helalsaeed2003/RoboticArm.github.io/literature-review.md

# Background – Literature Review

[← Back to Home](index.md)

---

*(To be updated with literature on robotic arm design, pick-and-place automation, computer vision in robotics, and vacuum gripping systems.)*
