helalsaeed2003/RoboticArm.github.io/resources.md

# Resources – Pre-Existing Software & Hardware

[← Back to Home](index.md)

---

## Software

- **Autodesk Inventor** – CAD modeling
- **Arduino IDE** – Firmware development
- **Python 3** – PC-side control application (`opencv-python`, `pygame`, `pyserial`, `numpy`)
- **ROS2** – Robot middleware (planned)
- **Gazebo** – Digital twin simulation (planned)

## Hardware

- Arduino R4
- L293D Motor Shield
- MG996R Servos (×3)
- JGA25-370 DC Gearmotor with Quadrature Encoder
- USB Camera
- IMU Sensor
- Vacuum Suction Cup + Pump (TBD)
- 3D Printed Structural Parts
