helalsaeed2003/RoboticArm.github.io/pages/presentations.md

# Weekly Presentations

[← Back to Home](../index.md)

---

These are the weekly progress presentations delivered throughout the MEC 483 semester. Each slide deck covers what was accomplished that week, blockers encountered, and plans for the next sprint. They document the project's evolution from initial concept through final integration.

---

| Week | Presentation | Focus |
|---|---|---|
| 2 | [RoboticArm_Week2.pptx](../media/PowerPoints/RoboticArm_Week2.pptx) | Project proposal and initial scope definition |
| 3 | [RoboticArm_Week3.pptx](../media/PowerPoints/RoboticArm_Week3.pptx) | Requirements gathering and component selection |
| 4 | [RoboticArm_Week4.pptx](../media/PowerPoints/RoboticArm_Week4.pptx) | Mechanical design and CAD modelling |
| 5 | [RoboticArm_Week5.pptx](../media/PowerPoints/RoboticArm_Week5.pptx) | Electrical schematic and power system layout |
| 6 | [RoboticArm_Week6.pptx](../media/PowerPoints/RoboticArm_Week6.pptx) | Firmware development and servo testing |
| 7 | [RoboticArm_Week7.pptx](../media/PowerPoints/RoboticArm_Week7.pptx) | Computer vision pipeline and YOLOv11 training |
| 8 | [RoboticArm_Week8.pptx](../media/PowerPoints/RoboticArm_Week8.pptx) | Manual control interface and gamepad integration |
| 10 | [RoboticArm_Week10.pptx](../media/PowerPoints/RoboticArm_Week10.pptx) | System integration and automatic mode testing |
| 11 | [RoboticArm_Week11.pptx](../media/PowerPoints/RoboticArm_Week11.pptx) | End effector validation and pick testing |
| 12 | [RoboticArm_Week12.pptx](../media/PowerPoints/RoboticArm_Week12.pptx) | Final demo, results, and lessons learned |

> Week 9 was a university break — no presentation that week.

---

[← Back to Home](../index.md)
