helalsaeed2003/RoboticArm.github.io/pages/references.md

# References

[← Back to Home](../index.md)

---

1. W. Bolton, *Mechatronics: Electronic Control Systems in Mechanical and Electrical Engineering*, 7th ed., Harlow, U.K.: Pearson, 2019.
2. M. W. Spong, S. Hutchinson, M. Vidyasagar, *Robot Modeling and Control*, 2nd ed., Wiley, 2020.
3. J. J. Craig, *Introduction to Robotics: Mechanics and Control*, 4th ed., Pearson, 2018.
4. N. S. Nise, *Control Systems Engineering*, 8th ed., Wiley, 2019.
5. J. Redmon, S. Divvala, R. Girshick, A. Farhadi, "You Only Look Once: Unified, Real-Time Object Detection," *IEEE CVPR*, 2016.
6. G. Bradski, A. Kaehler, *Learning OpenCV*, O'Reilly Media, 2008.
7. G. Jocher, A. Chaurasia, J. Qiu, "Ultralytics YOLOv11," 2024. https://github.com/ultralytics/ultralytics
8. M. Quigley et al., "ROS: An Open-Source Robot Operating System," *ICRA Workshop on Open Source Software*, 2009.
9. InvenSense, *MPU-6000 and MPU-6050 Product Specification*, rev. 3.4, 2013.
10. STMicroelectronics, *L298 Dual Full-Bridge Driver Datasheet*. https://www.st.com/resource/en/datasheet/l298.pdf
11. Tower Pro, *MG996R High-Torque Metal-Gear Servo Datasheet*, 2019.
12. Roboflow Inc., "Roboflow: Annotate, Train, and Deploy Computer-Vision Models," 2024. https://roboflow.com/
13. Processing Foundation, "Processing — A Flexible Software Sketchbook," 2024. https://processing.org/
14. P. Lager, "GameControlPlus Library for Processing," 2018. http://www.lagers.org.uk/gamecontrol

---

[← Back to Home](../index.md)
