helalsaeed2003/RoboticArm.github.io/Pages/prototype.md

# Prototype Construction

[← Back to Home](../index.md)

---

## Initial Design

- CAD model designed in Autodesk Inventor with ~400 mm reach
- Parts scaled and prepared for 3D printing
- Motor mounting holes and wiring channels added
- Wrist joint and end effector CAD in progress

## Final Design

*(To be updated after fabrication and assembly.)*
