helalsaeed2003/RoboticArm.github.io/media/PowerPoints/RoboticArm_Week10.pptx

WEEK 10

Robotic Arm

Pick & Place System

Weekly Progress Report · Mechatronics System Design 101

Leen's Group · Leen · Mohamed · Helal

## Slide 2

What we worked on this week

Week 10 — Snapshot

Status

Pump & relay working

12V pump, relay module, and lithium batteries wired up and controlled via Arduino. Relay successfully activates and deactivates the pump on command.

ROS2 — arm in environment

CAD model now appears at correct positions in ROS2 environment. Arm joints are controllable and can be manipulated in simulation.

Pump / relay

Working ✓

01

02

ROS2 / RViz

Working ✓

Arm assembly

Stable ✓

Arm assembly — stable

New screws procured — arm fits together perfectly and is structurally stable. Wheels received and ready to attach once base is complete.

Mobile base — laser cut

Laser cut base attempted twice — both broke. Redesigning with a simpler geometry before the third attempt.

Mobile base

03

04

Redesigning

End effector

In progress

Full assembly

Mechatronics System Design 101 · Leen's Group · Week 10

✓ Major progress: pump + relay operational, ROS2 arm controllable in simulation, arm structurally stable.

Pending

## Slide 3

Project Schedule — Gantt Chart

[ Paste Gantt Chart Image Here ]

Mechatronics System Design 101 · Leen's Group · Week 10

## Slide 4

Project Schedule — Gantt Chart

[ Paste Gantt Chart Image Here ]

Mechatronics System Design 101 · Leen's Group · Week 7

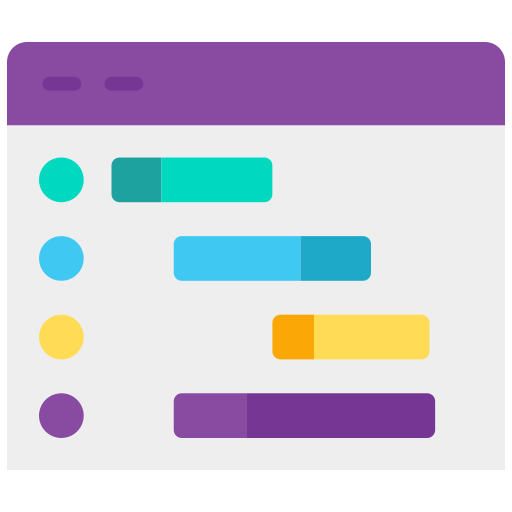
[picture p39: figure]

## Slide 5

Milestones & Deliverables

Deliverable

Target

Status

This week

CAD model complete

Week 10

Complete ✓

All links modelled — arm fits and is stable

Pump & relay control

Week 10

Done ✓

12V pump activated via relay and Arduino

ROS2 / Digital twin

Week 10

Working ✓

Arm at correct positions, joints manipulable

End effector (gripper)

Week 10

In progress

3D printing gripper design in progress

Mobile base

Week 10

Redesigning

Laser cut failed twice — simpler design planned

Full assembly

Week 11

Pending

Waiting on base and end effector completion

Control complete

Week 11

On track

Gamepad + Python + CV + relay all functional

Mechatronics System Design 101 · Leen's Group · Week 10

## Slide 6

Issues, Risks & Action Items

Current issues & risks

Mobile base — laser cut failing

Two laser cut attempts broke. Root cause: design too complex for the material. Redesigning with simpler geometry before third attempt.

Action items

Redesign base — simpler geometry

All

High

Week 11

End effector not yet complete

Gripper being 3D printed. End effector assembly cannot be finalised until print is complete and fit is verified.

Third laser cut attempt

All

Week 11

High

Complete gripper 3D print

Mohamed

Week 11

Attach wheels once base is ready

All

Full assembly blocked

Cannot fully assemble the system until both the mobile base and end effector are ready.

Medium

Week 11

Full system assembly

All

Week 11

Box dimensions still unknown

Professor has not yet provided box dimensions — coordinate mapping and arm positioning cannot be fully finalised.

Medium

Request box dimensions from professor

Leen

Week 11

Mechatronics System Design 101 · Leen's Group · Week 10

## Slide 7

Helal

Member

Individual

Updates

What each member did, what they will do, what they need.

Leen

Group Leader

Mohamed

Member

## Slide 8

Leen — Group Leader · ROS2 & Simulation

Accomplished (since last report)

- CAD model imported into ROS2 environment at correct joint positions

- Arm joints are now manipulable in the simulation

- Digital twin reflects the physical arm structure accurately

ROS2 / Digital twin — where we are

Installed & configured ✓

Installed and running ✓

Model at correct positions ✓

Joints manipulable in sim ✓

ROS2 ↔ Arduino — in progress

Ubuntu VM

ROS2

CAD import

In progress

- Linking ROS2 simulation to real Arduino control pipeline

- Finalising coordinate mapping for auto pick-and-place

Joint control

Arduino link

Full demo

Pending full assembly

Next week plan

- Connect ROS2 to Arduino for real-time joint control

- Complete full auto pick-and-place pipeline

- Request box dimensions from professor

Help needed / questions

Box dimensions still needed from professor to finalise arm positioning and coordinate mapping for pick-and-place.

Mechatronics System Design 101 · Leen's Group · Week 10

## Slide 9

Mohamed — Member

Accomplished (since last report)

[ To be filled in by Mohamed ]

Evidence (show, don't tell)

[ To be filled in by Mohamed ]

In progress

[ To be filled in by Mohamed ]

Help needed / questions

[ To be filled in by Mohamed ]

Next week plan

[ To be filled in by Mohamed ]

Mechatronics System Design 101 · Leen's Group · Week 10

## Slide 10

Helal — Member · Hardware & Assembly

Accomplished (since last report)

- Procured 12V pump, relay module, lithium batteries and case

- Wired relay module to Arduino — pump activates and deactivates on command

- Procured new screws — arm fits together and is structurally stable

- Received wheels — ready to attach once base is complete

- Laser cut base attempted twice — both attempts broke

Electrical system — what was bought

12V DC mini vacuum pump

3× 3.7V lithium batteries in series (~11.1V)

Relay module — Arduino-controlled on/off for pump

2× DC motors + wheels for mobile base

L298D motor driver shield for DC motors

New M3 screws — arm assembly now stable

Pump

Power

Relay

Motors

In progress

- Redesigning base with simpler geometry for third laser cut attempt

Driver

Screws

Help needed / questions

Base material and design needs to be validated before cutting again — two failed attempts. Need to confirm final dimensions and cut settings before third attempt.

Next week plan

- Third laser cut attempt with simplified base design

- Attach wheels and DC motors to base

- Begin full system assembly

Mechatronics System Design 101 · Leen's Group · Week 10

## Slide 11

Looking ahead

Week 10

Wrap-up

✓

✓

Pump + relay + batteries — working and controlled by Arduino

ROS2 arm at correct positions in simulation — joints manipulable

Week 11

Simplified base — third laser cut

✓

Arm structurally stable — new screws fit perfectly

Finish gripper + end effector

✓

Wheels and DC motors received

Week 11

Attach wheels + motors to base

⚠

Mobile base laser cut failed twice — redesigning for third attempt

Week 11

Full system assembly

⚠

End effector / gripper still being 3D printed

Week 11

ROS2 ↔ Arduino live link

Full pick-and-place demo

✗

Box dimensions still not received from professor

Week 11

Week 11

Mechatronics System Design 101 · Leen's Group · Week 10
