helalsaeed2003/RoboticArm.github.io/media/PowerPoints/RoboticArm_Week11.pptx

WEEK 11

Robotic Arm

Pick & Place System

Weekly Progress Report · Mechatronics System Design 101

Leen's Group · Leen · Mohamed · Helal

## Slide 2

Week 11 — Snapshot

What we worked on this week

Status

Full manual control working

Gamepad now controls wheel motors, all servo joints, and the pump in a single unified control loop. Full manual operation of the system confirmed.

Mobile base — laser cut done

Two platforms successfully laser cut. Standoffs procured to space them apart. Base structure is coming together.

Manual control

Working ✓

01

02

Mobile base

In progress

ROS2

In progress

CAD — scale verification needed

Further progress on CAD model. Printed parts need to be measured and compared to CAD to correct any scale discrepancies.

Detection — retraining model

Collected more images in a crowded environment. Model will be retrained to improve detection accuracy in realistic conditions.

CAD

03

04

Scale check

Detection

Retraining

End effector

✓ Major win: full manual control of wheels, servos, and pump confirmed working from a single gamepad.

Mechatronics System Design 101 · Leen's Group · Week 11

No update

## Slide 3

Project Schedule — Gantt Chart

[ Paste Gantt Chart Image Here ]

Mechatronics System Design 101 · Leen's Group · Week 11

## Slide 4

Milestones & Deliverables

Deliverable

Target

Status

This week

Manual control (full)

Week 11

Done ✓

Wheels + servos + pump via gamepad — all working

Mobile base

Week 11

In progress

Two platforms laser cut — standoffs fitted

CAD model

Week 11

Scale check

Progress made — need to verify printed part dimensions

Detection model

Week 11

Retraining

More images collected — model retraining in progress

ROS2 / Digital twin

Week 11

In progress

Joint positions not yet connecting correctly

End effector

Week 11

No update

Gripper 3D print status unchanged

Full system assembly

Week 11

Pending

Waiting on base, end effector, and CAD scale fix

Mechatronics System Design 101 · Leen's Group · Week 11

## Slide 5

Issues, Risks & Action Items

Current issues & risks

ROS2 — joints not connecting

Worked on ROS2 this week but arm parts are not connecting at the correct positions in the simulation. Configuration still needed.

Action items

Fix ROS2 joint connection positions

Mohamed

High

Next week

CAD scale discrepancy

Printed parts may not match CAD dimensions exactly. Need to measure and compare before adjusting the model.

Measure printed parts vs CAD — adjust

Helal

Next week

Medium

Retrain detection model

Leen

Next week

Resolve end effector / gripper

Mohamed

End effector — no progress

Gripper 3D print has had no update. End effector assembly cannot proceed until this is resolved.

Medium

Next week

Complete base — attach wheels & motors

Helal

Next week

Full assembly still pending

Assembly blocked until base is complete, end effector is ready, and CAD scale is confirmed.

Medium

Begin full system assembly

All

Next week

Mechatronics System Design 101 · Leen's Group · Week 11

## Slide 6

Individual

Updates

What each member did, what they will do, what they need.

Helal

Member

Leen

Group Leader

Mohamed

Member

## Slide 7

Leen — Group Leader · Detection & Image Collection

Accomplished (since last report)

- Collected additional training images in a crowded environment

- Images captured across varied lighting and background conditions

- Dataset prepared — model retraining queued

Why crowded environment training?

Earlier model trained on clean backgrounds — fails when other objects or clutter are present

New images captured with multiple objects in frame — teaches model to isolate the target

Robust detection in real lab conditions regardless of surrounding clutter

Problem

Solution

In progress

- Retraining detection model on expanded crowded-environment dataset

Goal

Next week plan

- Complete model retraining and evaluate accuracy

- Test retrained model on live camera feed

- Integrate updated detection with Arduino command pipeline

- Finalise coordinate mapping once box dimensions are confirmed

Help needed / questions

Box dimensions still needed from professor — coordinate mapping for the pick-and-place sequence cannot be finalised without knowing where the boxes will be placed.

Mechatronics System Design 101 · Leen's Group · Week 11

## Slide 8

Mohamed — Member · ROS2 Integration

Accomplished (since last report)

- Continued work on ROS2 — arm model loaded into simulation environment

ROS2 / Digital twin — current state

Installed & running ✓

Installed & running ✓

Model loaded in sim ✓

Not connecting correctly — in progress

Not yet started

Pending joint fix + assembly

Ubuntu VM

ROS2

In progress

- Arm parts not yet connecting at correct positions in ROS2 — joint transforms being debugged

CAD import

Joint positions

Arduino link

Next week plan

- Fix joint transform positions in URDF

- Verify arm model matches physical arm geometry

- Begin ROS2 ↔ Arduino live control link

- Resolve end effector / gripper status

Full demo

Help needed / questions

URDF joint transforms are not placing parts at correct positions — need to review axis definitions and parent-child relationships in the URDF file.

Mechatronics System Design 101 · Leen's Group · Week 11

## Slide 9

Helal — Member · Control, CAD & Base

Accomplished (since last report)

- Completed unified manual control code — gamepad drives wheel motors, actuates all servo joints, and activates pump simultaneously

- Two base platforms successfully laser cut

- Standoffs procured to space the two platforms apart

- Further progress on CAD model

Manual control — what the gamepad controls

Drive wheel motors — forward / backward / turn

Shoulder and elbow servo joints

Wrist servo — up/down

Pump on/off via relay

Base joint rotation

Left stick

Right stick

Triggers

Buttons

Bumpers

In progress

- Measuring printed parts to check scale against CAD model

Single unified Arduino firmware sketch

All modes

Help needed / questions

Printed parts may be scaled down relative to the CAD. Need to physically measure each part and update the CAD before the model can be used for final assembly planning.

Next week plan

- Adjust CAD model based on measured part dimensions

- Assemble base — attach wheels and DC motors

- Begin full system assembly

Mechatronics System Design 101 · Leen's Group · Week 11

## Slide 10

Looking ahead

Week 11

Wrap-up

Full manual control — wheels, servos, and pump via single gamepad

✓

Fix ROS2 joint transforms

Next

Mobile base platforms laser cut — standoffs fitted

✓

Retrain + test detection model

More training images collected in crowded environment

CAD scale needs verification against printed parts

✓

⚠

Verify CAD scale + adjust

Next

ROS2 joint positions not yet connecting correctly

⚠

Assemble base + attach wheels

Next

End effector / gripper — no update this week

⚠

Next

Resolve end effector

Full system assembly + demo

Next

Next

Mechatronics System Design 101 · Leen's Group · Week 11
