helalsaeed2003/RoboticArm.github.io/media/PowerPoints/RoboticArm_Week12.pptx

WEEK 12

Robotic Arm

Pick & Place System

Weekly Progress Report · Mechatronics System Design 101

Leen's Group · Leen · Mohamed · Helal

## Slide 2

Week 12 — Snapshot

What we worked on this week

Status

Detection — simplified & improved

Decided egg and ball are similar enough in size — system detects object presence rather than classifying type. Detection now more reliable and practical.

End effector — parts acquired

Tube, connector, and suction cup procured. Gripper still needs to be printed. One connecting part failed to print and needs to be reprinted.

Mobile base

Assembled ✓

01

02

Detection

Simplified ✓

Pump

Tested ✓

Mobile base — fully assembled

Both platforms drilled, 4 columns fitted between them, wheels on bottom platform, hole in top platform for wire routing. Arduino seated between the two bases.

Pump — tested

Pump tested with the suction cup and tubing. Suction force verified on representative objects.

End effector

03

04

In progress

Gripper print

Pending

Full assembly

✓ Major win: mobile base fully assembled — wheels, columns, wire routing, and Arduino housing all complete.

Mechatronics System Design 101 · Leen's Group · Week 12

Near ready

## Slide 3

Project Schedule — Gantt Chart

[ Paste Gantt Chart Image Here ]

Mechatronics System Design 101 · Leen's Group · Week 12

## Slide 4

Milestones & Deliverables

Deliverable

Target

Status

This week

Mobile base

Week 12

Done ✓

Drilled, columns fitted, wheels on, wire hole cut

Detection system

Week 12

Done ✓

Simplified — detects object presence reliably

Pump testing

Week 12

Done ✓

Suction confirmed working with tube and cup

End effector (suction)

Week 12

In progress

Tube, connector, cup acquired — needs connector part reprint

Gripper print

Week 12

Pending

Still needs to be printed

Full assembly

Week 12

Near ready

Blocked only by gripper and failed part reprint

Control complete

Week 12

On track

Manual control fully working — auto pending CV

Mechatronics System Design 101 · Leen's Group · Week 12

## Slide 5

Issues, Risks & Action Items

Current issues & risks

Failed part print — end effector

One part that connects to the end effector failed to print. Needs to be reprinted before the end effector can be fully assembled.

Action items

Reprint failed end effector connector

Helal

High

Next week

Gripper not yet printed

Gripper design still needs to be printed. End effector assembly cannot be completed until this is done.

Print gripper

Mohamed

Next week

High

Assemble full end effector

All

Next week

Full system assembly

All

Full assembly pending

All other components are ready — assembly is blocked only by the two missing printed parts.

Medium

Next week

Fix ROS2 joint transforms

Mohamed

Next week

ROS2 joint positions

Joint connection issue from last week not yet resolved. Integration with live control still pending.

Medium

Test full pick-and-place cycle

All

Next week

Mechatronics System Design 101 · Leen's Group · Week 12

## Slide 6

Individual

Updates

What each member did, what they will do, what they need.

Helal

Member

Leen

Group Leader

Mohamed

Member

## Slide 7

Leen — Group Leader · Detection & End Effector

Accomplished (since last report)

- Improved and simplified detection system — egg and ball treated as same object category since sizes are nearly identical

- System now detects object presence reliably without needing exact classification

- Procured suction tube, connector, and suction cup for end effector assembly

Detection — design decision

Classify object type (bolt, egg, ball) separately — complex and error-prone

Detect that an object is present and in range — simpler and more reliable

Egg and ball are nearly identical in size — separate classification adds unnecessary complexity

Detection is now faster, more reliable, and easier to integrate with the control pipeline

Old approach

New approach

Justification

In progress

- Integrating updated detection with the full auto control pipeline

Result

End effector — parts status

Procured ✓

Procured ✓

Procured ✓

Next week plan

- Complete end effector assembly once reprints arrive

- Test full detection-to-command pipeline

- Begin full pick-and-place cycle testing

Suction cup

Tube

Connector

Failed — needs reprint

Connector part (3D print)

Mechatronics System Design 101 · Leen's Group · Week 12

Not yet printed

Gripper

## Slide 8

Mohamed — Member · Base Assembly & Pump Testing

Accomplished (since last report)

- Assisted with drilling both circular base platforms

- Helped assemble base structure — columns, wheels, and wire routing hole

- Tested pump suction with tube and cup — confirmed working on representative objects

Pump test results

Picked up successfully ✓

Picked up successfully ✓

Picked up successfully ✓

Cup seals on flat and curved surfaces ✓

Bolt

Ball

Egg

In progress

- Gripper design — needs to be printed

Seal

Help needed / questions

Gripper print is the last remaining blocker for end effector completion. Once printed and assembled, full system testing can begin. ROS2 joint transform issue still needs to be resolved before digital twin can mirror real arm.

Next week plan

- Print gripper

- Assemble full end effector

- Fix ROS2 joint position issue

- Begin full system assembly and testing

Mechatronics System Design 101 · Leen's Group · Week 12

## Slide 9

Helal — Member · Base Assembly & End Effector

Accomplished (since last report)

- Drilled both circular base platforms

- Fitted 4 standoff columns between the two platforms

- Attached wheels to bottom platform

- Cut wire routing hole in top platform

- Arduino seated and secured between the two platforms

- Procured suction tube, connector, and suction cup

Mobile base — what was built

Circular — drilled — wire hole cut for Arduino wiring

Seated between platforms — wires routed through top hole

4× standoffs spacing the two platforms apart

Circular — drilled — wheels attached underneath

DC motors + wheels on bottom for mobile movement

Batteries and relay housed in base structure

Top platform

Arduino

Columns

Bottom platform

In progress

- Reprint of failed end effector connector part

Wheels

Power

Next week plan

- Reprint connector part and assemble end effector

- Attach wheels and DC motors to base

- Begin full system assembly

Help needed / questions

Connector part reprint is the only remaining blocker before end effector can be assembled.

Mechatronics System Design 101 · Leen's Group · Week 12

## Slide 10

Looking ahead

Week 12

Wrap-up

Mobile base fully assembled — drilled, columns, wheels, wire routing

Detection simplified — object presence detection, egg/ball treated as one

✓

✓

Reprint connector + print gripper

Next

Pump tested — all three objects picked up successfully

✓

Assemble full end effector

End effector parts procured — tube, connector, suction cup

✓

Attach wheels + motors to base

Next

Connector part failed to print — needs reprinting

⚠

Full system assembly

Next

Gripper not yet printed — last blocker for end effector

⚠

Next

Fix ROS2 joint transforms

Full pick-and-place demo

ROS2 joint positions still not resolved

⚠

Next

Next

Mechatronics System Design 101 · Leen's Group · Week 12
