helalsaeed2003/RoboticArm.github.io/media/PowerPoints/RoboticArm_Week4.pptx

WEEK 4

Robotic Arm

Pick & Place System

Weekly Progress Report · Mechatronics System Design 101

March 25 – March 31, 2025

Leen's Group · Leen · Mohamed · Helal

## Slide 2

Week 4 — Snapshot

What we worked on this week

CAD model update

Continued refining the arm model in Autodesk Inventor. Wrist joint and end effector mount still in progress — geometry for base, shoulder, and elbow is locked.

Status

Schedule

On track

01

OpenCV — computer vision

Started setting up the OpenCV pipeline on the PC. Color/shape-based object detection approach being prototyped — no AI training required.

Scope

Defined

02

CAD

In progress

Hardware

Procured

Electrical components & code

Procured electrical components including Arduino R3, motor driver, and servo set. Began bench testing of Arduino code — basic servo PWM control verified and responding correctly.

03

Code

Testing

Mechatronics System Design 101 · Leen's Group · Week 4

⚠ CAD wrist joint and end effector mount still require work — targeted for completion by Week 6.

## Slide 3

Project Schedule — Gantt Chart

[ Paste Gantt Chart Image Here ]

Mechatronics System Design 101 · Leen's Group · Week 4

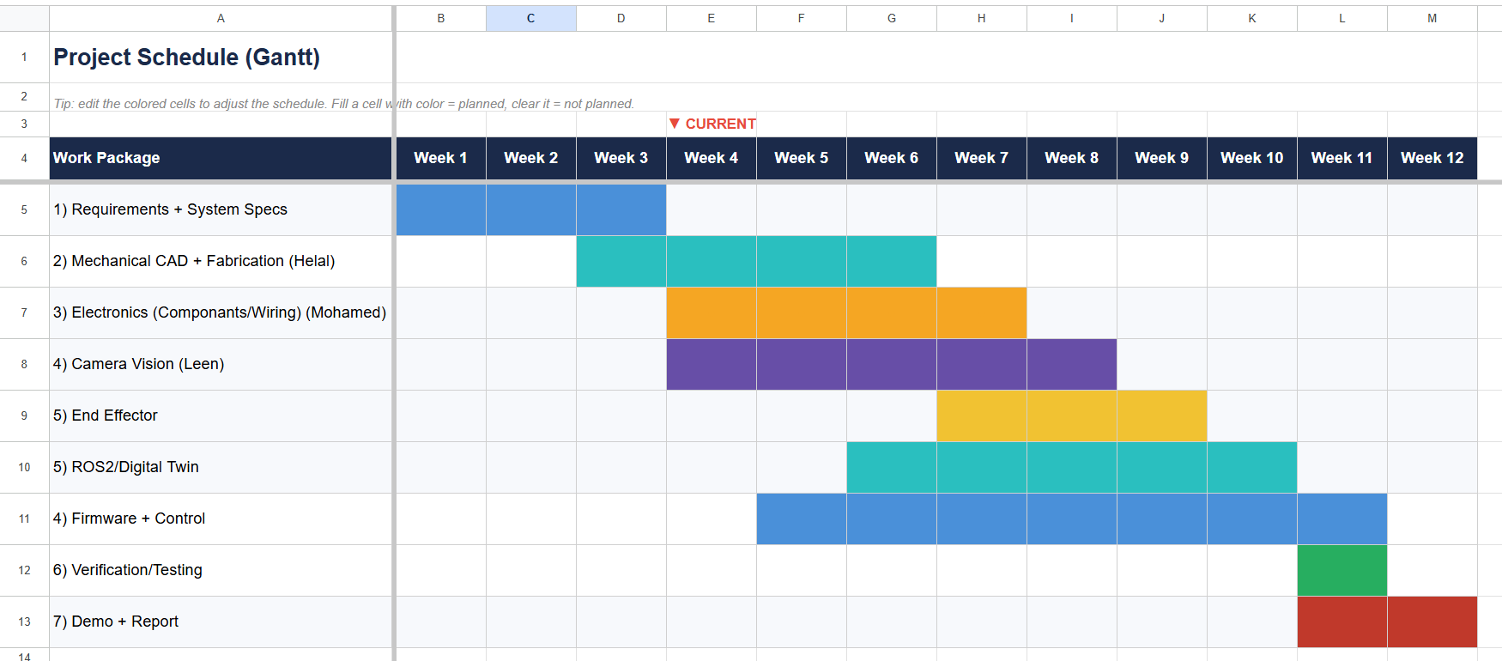
[picture p40: figure]

## Slide 4

Milestones & Deliverables

Deliverable

Target

Status

Progress this week

CAD model complete

Week 6

In progress

Base/shoulder/elbow done. Wrist & EE mount in progress.

Camera vision (OpenCV)

Week 8

Started

Color/shape detection pipeline being prototyped on PC.

End effector

Week 9

Planned

Custom design pending CAD completion. Pump/Comp TBD.

ROS2 & digital twin

Week 10

Started

ROS2 environment set up. Gazebo simulation begun.

Full assembly

Week 10

Planned

3D printing of parts started for early fit testing.

Control system integration

Week 11

Planned

PC + Arduino R4 serial comms. Arduino code prototyped.

✓ This week: electrical components procured, 3D printing of arm parts started, Arduino code testing begun.

Mechatronics System Design 101 · Leen's Group · Week 4

## Slide 5

Issues, Risks & Actions

Current issues & risks

Suction pump undecided

Still evaluating mini compressor vs micro diaphragm pump vs venturi. Affects end effector timeline.

Actions & mitigations

Pump selection

Test available options in lab Week 5 — select based on suction force and size fit.

Medium

Pending

CAD wrist & end effector

Wrist joint and end effector mount geometry not yet finalised — blocking 3D print of those parts.

Medium

CAD completion

Wrist and EE mount to be finalised by Week 6. Scale and wiring routing to follow.

In progress

Team coordination

Difficulty scheduling meetings and exchanging work between members due to conflicting availability.

Team sync

Set a fixed weekly check-in slot. Use shared drive for exchanging files between members.

High

In progress

ROS2 learning curve

ROS2 and Gazebo are new to the team — early stage setup taking longer than anticipated.

High

ROS2 ramp-up

Team to follow ROS2 + Gazebo tutorials in parallel. Simple URDF model targeted for Week 6.

In progress

Mechatronics System Design 101 · Leen's Group · Week 4

## Slide 6

Helal

Member

Individual

Updates

What each member did, what they will do, what they need.

Leen

Group Leader

Mohamed

Member

## Slide 7

Leen — Group Leader · Vision & Detection

Accomplished (since last report)

- Secured and confirmed the camera to be used for the project

- Researched OpenCV vs YOLOv4 for object detection

- Decided on OpenCV color/shape detection — no training needed, better fit for controlled lab environment

OpenCV vs YOLOv4 — decision rationale

OpenCV ✓

- No training required

- Works with controlled lighting

- Simpler to implement & debug

YOLOv4 ✗

- Requires training data & GPU

- Overkill for a fixed lab setup

In progress

- Setting up OpenCV detection pipeline on PC with connected camera

Next week plan

- Begin implementing OpenCV detection script on PC

- Test camera feed and object detection on sample items

- Integrate detection output with serial command pipeline

Help needed / questions

No blockers this week. Camera secured and detection approach confirmed — ready to begin coding pipeline.

Mechatronics System Design 101 · Leen's Group · Week 4

## Slide 8

Leen — Group Leader · Vision & Detection

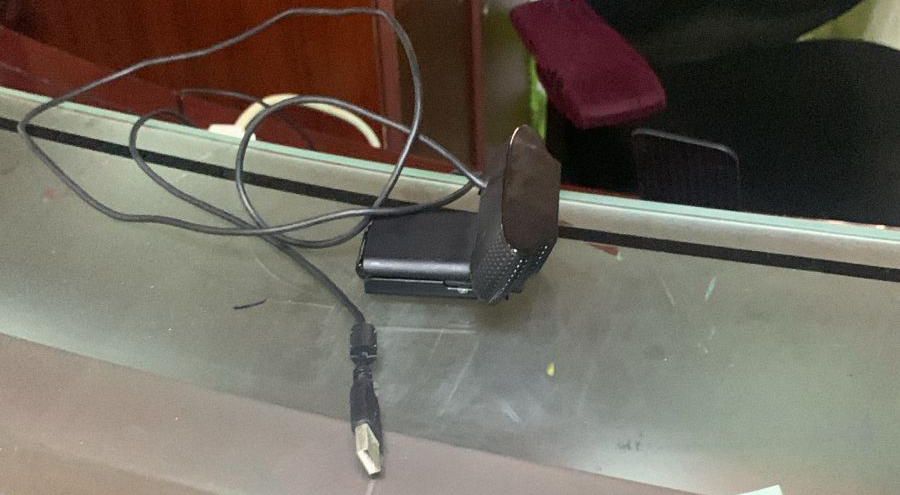
[picture p41: figure]

Mechatronics System Design 101 · Leen's Group · Week 4

## Slide 9

Mohamed — Member

Components Purchased

4× MG996R Servo Motors

L293D Motor Shield (H-Bridge)

400mm Male-Male Jumper Wires

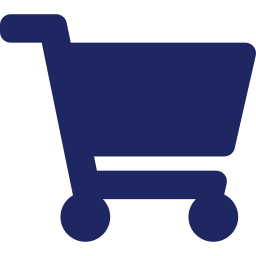
[picture p42: figure]

Arduino Code

2-DOF serial servo controller

Base & Shoulder joints (pins 9 & 10)

Serial command parsing

Input validation & status query

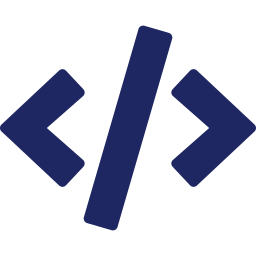
[picture p43: figure]

Week 4 • Mohamed • Robotic Arm Project

## Slide 10

Mohamed — Member

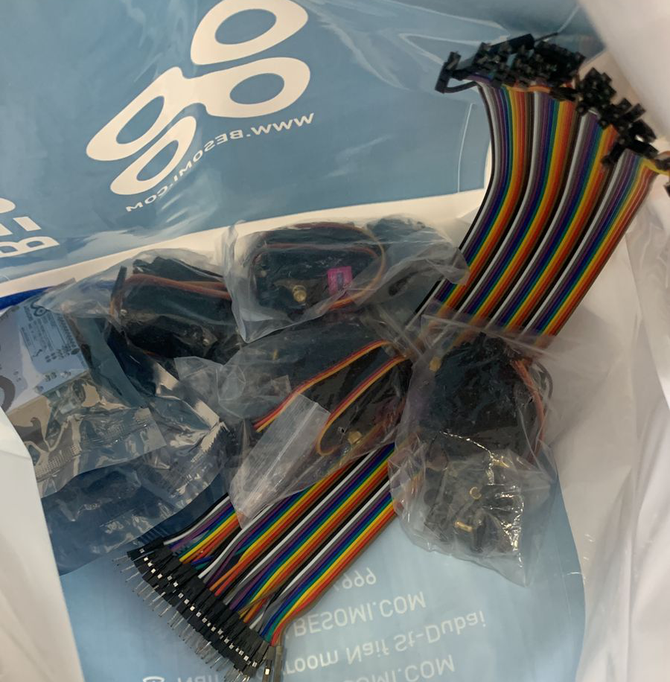
[picture p44: figure]

Week 4 • Mohamed • Robotic Arm Project

## Slide 11

Mohamed — Member
Components Purchased

MG996R Servo Motors ×4

Actuates the shoulder, elbow, wrist, and gripper joints

Torque: 9.4 kg·cm (4.8V) / 11 kg·cm (6V)

Speed: 0.17 s/60° at 4.8V

Angle range: 0°–180°

Protocol: PWM signal

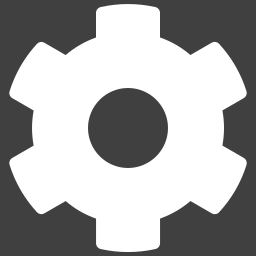
[picture p45: figure]

L293D Motor Shield

Interfaces servos and DC motor with the Arduino R4

Dual H-Bridge driver (L293D chip)

Servo headers on pins 9 & 10

Supports up to 4 DC motors

Direct stacking on Arduino

400mm Jumper Wires (M-M)

Internal wiring between components on the arm

Length: 400 mm

Type: Male-to-Male

Flexible routing for arm assembly

Week 4 • Mohamed • Robotic Arm Project

## Slide 12

Mohamed — Member
Arduino Code — 2-DOF Servo Controller

Arduino Sketch

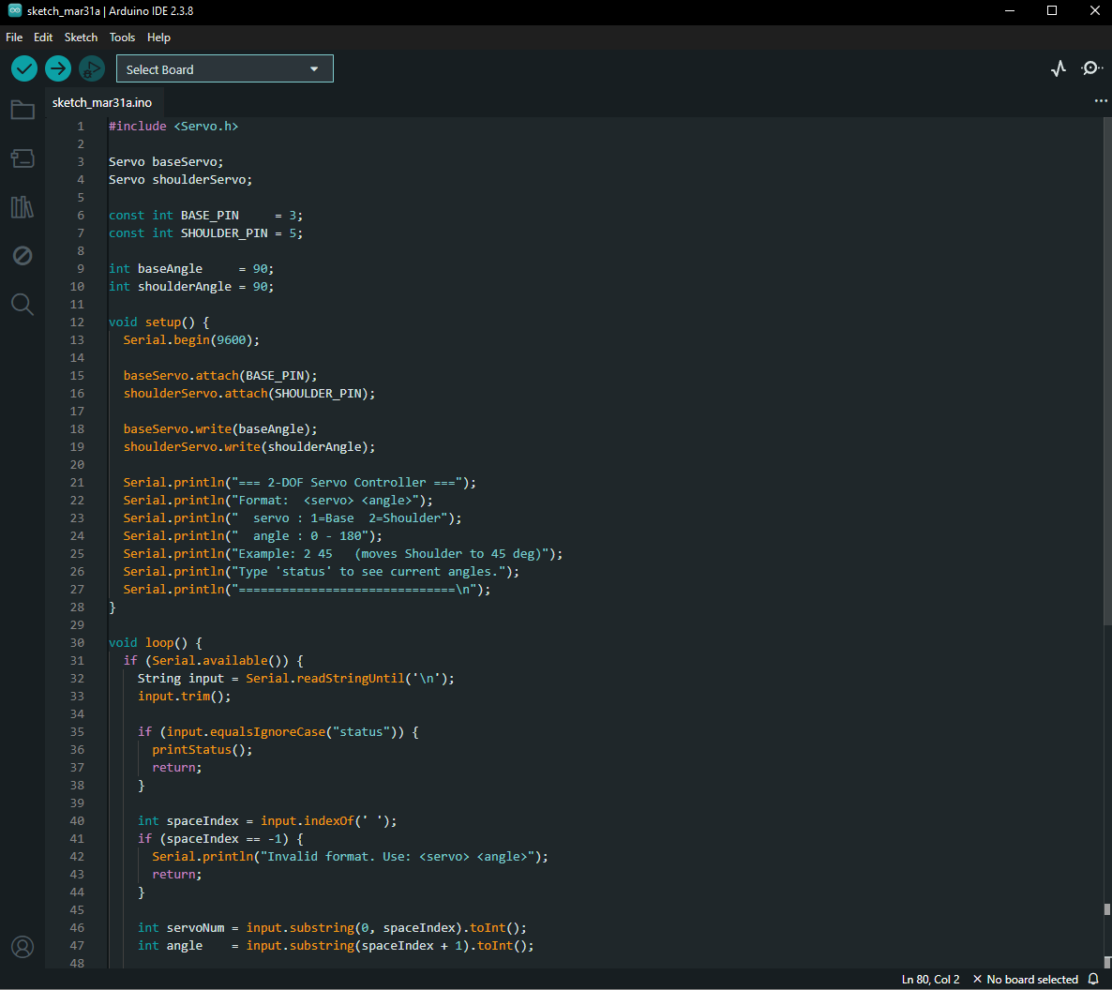
[picture p46: figure]

#include <Servo.h>

Servo baseServo, shoulderServo;
void setup() {
Serial.begin(9600);
baseServo.attach(9);
shoulderServo.attach(10);
}
void loop() {
// Parse serial command
// Format: <servo> <angle>
// e.g. 2 45

Serial Command Parsing

Accepts '<servo> <angle>' via USB serial from PC

Input Validation

Rejects invalid servo IDs and out-of-range angles (0–180°)

Status Query

Type 'status' to print current angles of both joints

L293D Shield

Servo headers on pins 9 (Base) & 10 (Shoulder)

Week 4 • Mohamed • Robotic Arm Project

## Slide 13

Mohamed — Member
Next Steps

Expand Arduino code to control all 4 MG996R servo joints

Integrate base DC gearmotor (JGA25-370) with PID control loop

Develop Python serial interface on PC to send commands

Test serial communication between PC (Python) and Arduino R4

Begin physical assembly of servo joints on the arm structure

Mechatronics System Design • Week 4 • Mohamed

## Slide 14

Helal — Member · CAD & 3D Printing

Accomplished (since last report)

- Scaled up part dimensions for better structural fit

- Added motor mounting screw holes and alignment fittings

- Designed internal wiring paths and cable channels

- Began 3D printing of completed parts for fit testing

Evidence (show, don't tell)

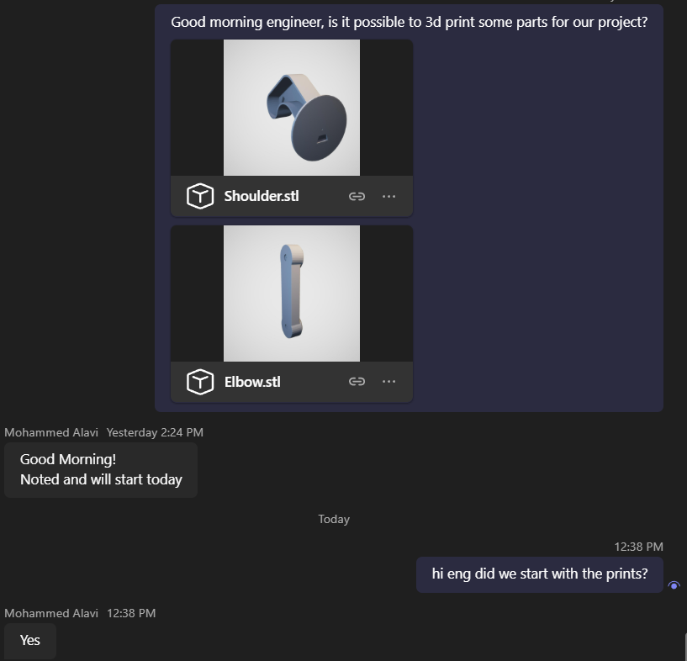
[picture p47: figure]
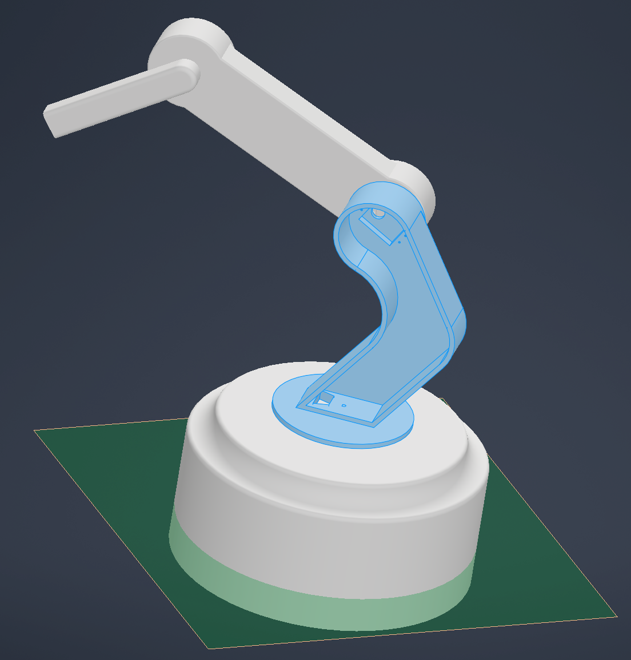
[picture p48: figure]

In progress

- 3D printing of arm link parts — ongoing as parts clear review

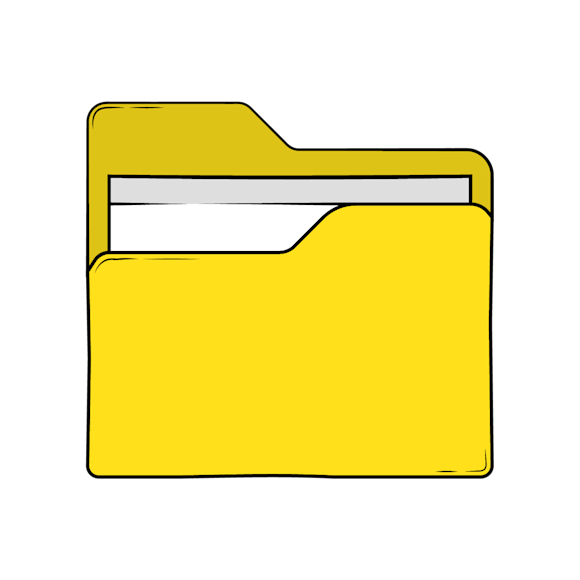
[picture p49: figure]

Help needed / questions

Finalising suction cup mount dimensions depends on pump selection — need pump decision to complete end effector CAD.

Next week plan

- Complete wrist joint CAD model

- Begin end effector CAD design

Mechatronics System Design 101 · Leen's Group · Week 4

## Slide 15

Looking ahead

Week 4

Wrap-up

✓

Camera secured — vision hardware confirmed

OpenCV pipeline + serial integration

✓

Detection approach decided: OpenCV, no AI training

Week 5

Pump testing & selection

✓

Electrical components procured, Arduino code tested

Week 5

CAD fully complete

✓

CAD updated — parts scaled, motor mounts & wiring channels added

Week 6

Camera vision system complete

⏳

CAD wrist joint & end effector still in progress (target Week 6)

Week 8

End effector complete

Assembly + digital twin (Gazebo)

⏳

Suction pump selection still pending

Week 9

Week 10

Mechatronics System Design 101 · Leen's Group · Week 4
