helalsaeed2003/RoboticArm.github.io/media/PowerPoints/RoboticArm_Week5.pptx

WEEK 5

Robotic Arm

Pick & Place System

Weekly Progress Report · Mechatronics System Design 101

April 1 – April 7, 2025

Leen's Group · Leen · Mohamed · Helal

## Slide 2

Week 5 — Snapshot

What we worked on this week

OpenCV — data collection

Began gathering image data for the objects to be picked up. Camera connected and capture pipeline initiated.

Status

Schedule

01

Behind

End effector design

Conducted suction force calculations for cup sizing. Explored alternative gripper concepts alongside the suction cup approach.

CAD

No progress

02

OpenCV

In progress

Manual motor control

Diagnosed incorrect motors (continuous rotation), sourced correct servos, then implemented full gamepad control via Firmata + Processing libraries.

03

End effector

Started

ROS2

⚠ CAD made no progress this week — now targeting Week 7. ROS2 has not been started — critically behind schedule.

Mechatronics System Design 101 · Leen's Group · Week 5

Not started

## Slide 3

Project Schedule — Gantt Chart

[ Paste Gantt Chart Image Here ]

Mechatronics System Design 101 · Leen's Group · Week 5

## Slide 4

Milestones & Deliverables

Deliverable

Target

Status

This week

CAD model complete

Week 7

Behind

No progress this week — 1 week delay

Camera vision (OpenCV)

Week 8

In progress

Collecting image data for detection

End effector design

Week 8

Started

Suction calculations done, alternatives reviewed

Manual motor control

Week 5

Done ✓

Gamepad control via Firmata + Processing working

ROS2 / Digital twin

Week 10

Not started

Critically behind — must begin Week 6

Full assembly

Week 10

Planned

3D printed parts ready, campus access needed

Control system complete

Week 11

Planned

PC + Arduino R4 pipeline being built

Mechatronics System Design 101 · Leen's Group · Week 5

## Slide 5

Issues, Risks & Action Items

Current issues & risks

CAD — no progress this week

Wrist joint and end effector mount remain incomplete. Now targeting Week 7 instead of Week 6.

Action items

Begin ROS2 + Gazebo setup immediately

All members

High

Week 6

ROS2 — not started

No work begun on ROS2 or Gazebo digital twin. Critically behind — required deliverable.

Resume CAD — complete wrist joint

Helal

Week 6

High

Arrange campus visit to collect 3D parts

Leen

Week 6

Continue OpenCV data collection

Leen

Campus access blocked

Finished 3D printed parts cannot be collected — team unable to get on campus this week.

Medium

Week 6

Finalise end effector calculations

Mohamed

Week 6

Team coordination difficulty

Ongoing difficulty scheduling meetings and exchanging files between members.

Low

Set up fixed weekly team sync

Leen

Ongoing

Mechatronics System Design 101 · Leen's Group · Week 5

## Slide 6

Individual

Updates

What each member did, what they will do, what they need.

Helal

Member

Leen

Group Leader

Mohamed

Member

## Slide 7

Leen — Group Leader

Accomplished (since last report)

Installed and configured Python and VS Code
✅ Installed Ultralytics and OpenCV libraries
✅ Wrote and tested the camera capture script
✅ Confirmed Logitech camera connection working at index 1
✅ Coordinated with team on OpenCV data collection setup

In progress

Evidence (show, don't tell)

Will Be Shown

In Progress

Continuing OpenCV data collection for training dataset
Preparing dataset upload and annotation on Roboflow

Help needed / questions

Next week plan

🔹 Step 3 — Upload and annotate photos on Roboflow
🔹 Step 4 — Train YOLOv8 model on Google Colab
🔹 Step 5 — Run live object detection using the camera feed

Mechatronics System Design 101 · Leen's Group · Week 5

## Slide 8

Mohamed — Member

Accomplished (since last report)

[ To be filled in by Mohamed ]

Evidence (show, don't tell)

[ To be filled in by Mohamed ]

In progress

[ To be filled in by Mohamed ]

Help needed / questions

[ To be filled in by Mohamed ]

Next week plan

[ To be filled in by Mohamed ]

Mechatronics System Design 101 · Leen's Group · Week 5

## Slide 9

Helal — Member · Motor Control & Arduino

Accomplished (since last report)

- Investigated how to control servos via Arduino + gamepad controller

- Wrote and tested initial Arduino code — confirmed working with controller

- Identified that motors supplied were continuous rotation (incorrect type)

- Returned incorrect motors and sourced correct positional servos

- Implemented full servo control using Firmata protocol in Arduino IDE

Technical implementation

Standard Firmata (Arduino IDE)

Processing IDE

G4P + GameControlPlus

Bluetooth gamepad via PC USB

Each motor controllable independently via gamepad axes

Protocol

Software

Libraries

Controller

Next week plan

- Resume CAD — complete wrist joint model

- Begin end effector CAD design

- Refine control mapping between gamepad axes and joint angles

Result

Issue resolved — wrong motors

Initial motors were continuous rotation type — no position control possible. Identified, returned, and replaced with correct positional servos on Apr 6.

CAD stalled this week — needs to resume Week 6 to meet Week 7 target.

Mechatronics System Design 101 · Leen's Group · Week 5

## Slide 10

Demo

Motor Control via Gamepad

Helal — Week 5 · Firmata + Processing + GameControlPlus

[ Insert video here ]

Mechatronics System Design 101 · Leen's Group · Week 5

To insert video in PowerPoint:

Insert tab

→ Video

▶

→ This Device

Select your file

## Slide 11

Looking ahead

Week 5

Wrap-up

Gamepad motor control working — correct servos sourced and tested

✓

Start ROS2 + Gazebo

Week 6

OpenCV data collection started — image pipeline connected

✓

Resume CAD — wrist joint

End effector suction calculations done, alternatives explored

CAD — no progress this week, now targeting Week 7

✓

⚠

Collect 3D printed parts

Week 6

ROS2 — not started, critically behind schedule

✗

OpenCV detection coding begins

Week 6

3D printed parts ready but not accessible — campus visit needed

⚠

Week 6

CAD fully complete

Vision + end effector complete

Week 7

Week 8

Mechatronics System Design 101 · Leen's Group · Week 5
