helalsaeed2003/RoboticArm.github.io/media/PowerPoints/RoboticArm_Week6.pptx

WEEK 6

Robotic Arm

Pick & Place System

Weekly Progress Report · Mechatronics System Design 101

Leen's Group · Leen · Mohamed · Helal

## Slide 2

Week 6 — Snapshot

What we worked on this week

OpenCV — object detection

Major progress: system can now detect and classify objects. Coordinate mapping to arm workspace not yet complete — commands cannot be sent until this is done.

Status

Schedule

Behind

01

Control system

Major progress: Arduino now controllable via gamepad (manual) and Python input commands (auto). Once CV coordinate mapping is done, the pipeline will be fully connected.

OpenCV

Near done

02

Control

Major prog.

IMU / EE

Working ✓

IMU — end effector levelling

IMU sensor integrated and working. The wrist joint now actively corrects to keep the end effector pointing downward at all times during arm movement.

03

ROS2

Just started

3D prints

Delayed

Mechatronics System Design 101 · Leen's Group · Week 6

⚠ 3D prints delayed again — reprinting required. CV coordinate mapping remaining before full auto pipeline is active.

## Slide 3

Project Schedule — Gantt Chart

[ Paste Gantt Chart Image Here ]

Mechatronics System Design 101 · Leen's Group · Week 6


## Slide 4

Milestones & Deliverables

Deliverable

Target

Status

This week

CAD model complete

Week 7

Behind

3D prints reprinting — parts delayed 2+ weeks

Camera vision (OpenCV)

Week 8

Near done

Detection & classification working. Coord. mapping remaining.

Control system

Week 8

Major prog.

Gamepad + Python commands both working on Arduino

IMU / end effector level

Week 8

Done ✓

Wrist joint auto-levels to keep cup pointing down

End effector design

Week 8

In progress

Pending CAD completion and pump selection

ROS2 / Digital twin

Week 10

Started

Ubuntu VM installed — beginning setup this week

Full assembly

Week 10

Blocked

Cannot assemble without 3D printed parts

Control system complete

Week 11

On track

Pipeline nearly ready pending CV mapping

Mechatronics System Design 101 · Leen's Group · Week 6

## Slide 5

Issues, Risks & Action Items

Current issues & risks

3D prints delayed — again

Parts sent 2 weeks ago were printed incorrectly. Reprinting now in progress — blocking full physical assembly.

Action items

Complete CV coordinate mapping

Leen

High

Week 7

OpenCV coordinate mapping

Object detection works but workspace coordinate mapping is incomplete — auto pipeline cannot send commands yet.

Follow up on 3D print status

Helal

Week 7

Medium

Resume & finalise CAD model

Helal

Week 7

Continue ROS2 environment setup

All

CAD still incomplete

Wrist joint and end effector mount not yet finalised — dependent on receiving 3D printed parts to verify fit.

Medium

Week 7

Finalise end effector calculations

Mohamed

Week 7

ROS2 — early stage

Ubuntu VM installed this week — ROS2 setup just beginning. Must accelerate to meet Week 10 target.

Medium

Finalise suction pump selection

Mohamed

Week 7

Mechatronics System Design 101 · Leen's Group · Week 6

## Slide 6

Helal

Member

Individual

Updates

What each member did, what they will do, what they need.

Leen

Group Leader

Mohamed

Member

## Slide 7

Leen — Group Leader · Computer Vision

Object detection pipeline — Week 6

01

Roboflow

Dataset labelling & export

247 images of 5 objects collected with Logitech camera. Manually annotated with bounding boxes on Roboflow. Dataset split into train / val / test sets and augmented.

02

Google Colab

YOLOv11 model training

Downloaded dataset from Roboflow into Colab. Trained YOLOv11 for 50 epochs on free T4 GPU. Downloaded best.pt weights to local machine.

Mechatronics System Design 101 · Leen's Group · Week 6

03

VS Code — live testing

detect.py on camera feed

Loaded best.pt in VS Code. Ran detection script against live Logitech camera feed. Confirmed Ball, Bolt, Compass, Egg, Screw detected with high confidence.

## Slide 8

Step 1 — Roboflow: Dataset Labelling

Evidence ✓

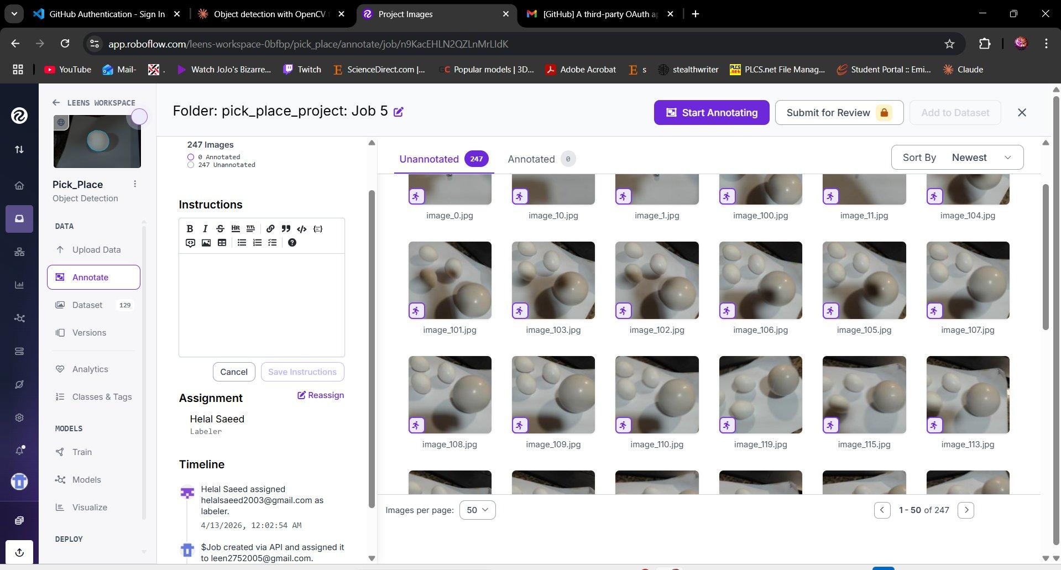
[picture p50: figure]

What we did in Roboflow

- 247 images collected of 5 target objects

- Objects: Ball, Bolt, Compass, Egg, Screw

- Bounding boxes drawn manually per image

- Class names assigned to each annotation

- Dataset split: train / validation / test

- Preprocessing: Auto-Orient, Resize, Auto-Contrast

- Augmentation: Flip, Rotation, Brightness

Mechatronics System Design 101 · Leen's Group · Week 6

## Slide 9

Step 2 — Google Colab: YOLOv11 Training

Evidence ✓

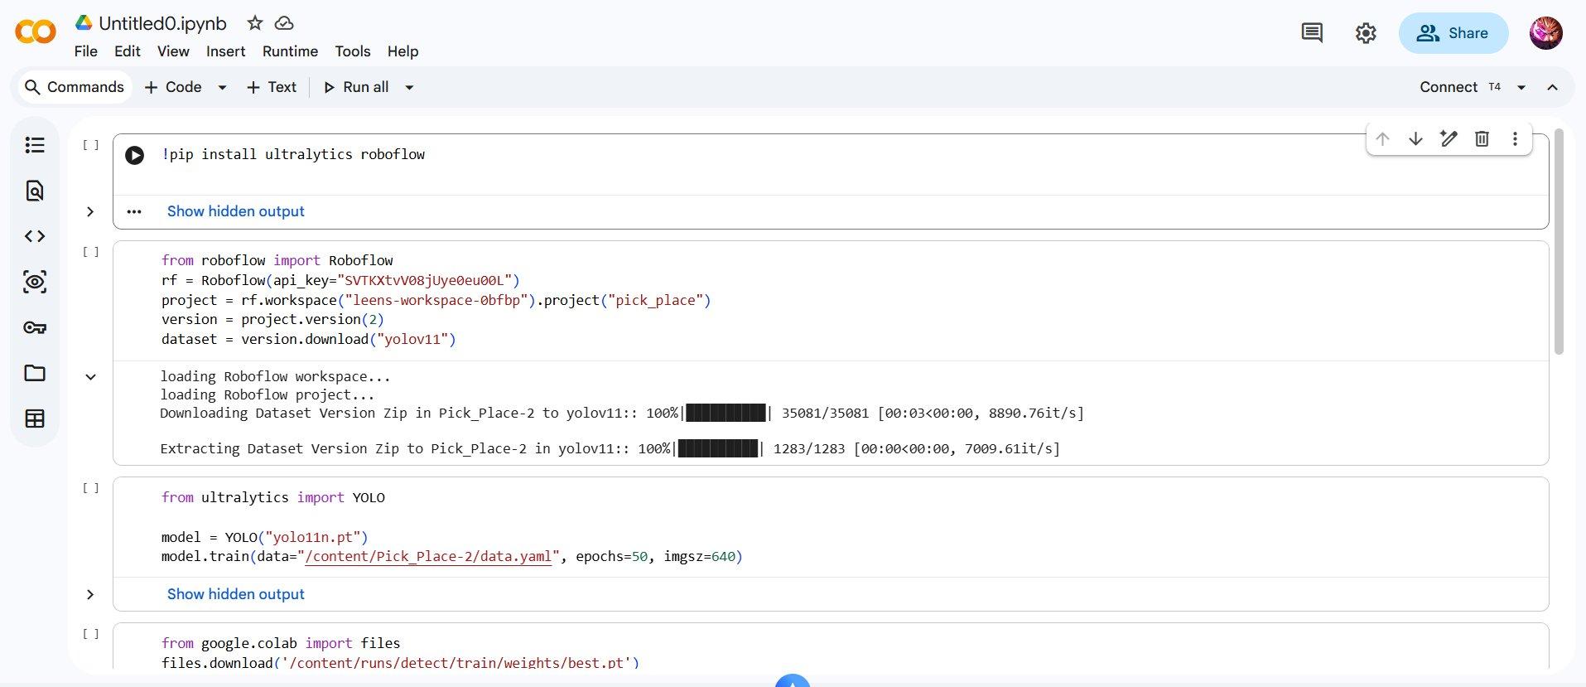
[picture p51: figure]

What we did in Colab

Why Colab?

Roboflow free plan doesn't allow model weight download

GPU

Free T4 cloud GPU — much faster than local CPU

Model

YOLOv11 (ultralytics)

Epochs

50

Image size

640 × 640

Dataset

Downloaded directly from Roboflow API

Output

best.pt weights downloaded to local machine

Mechatronics System Design 101 · Leen's Group · Week 6

## Slide 10

Step 3 — VS Code: Live Detection Testing

Working ✓

detect.py — the script

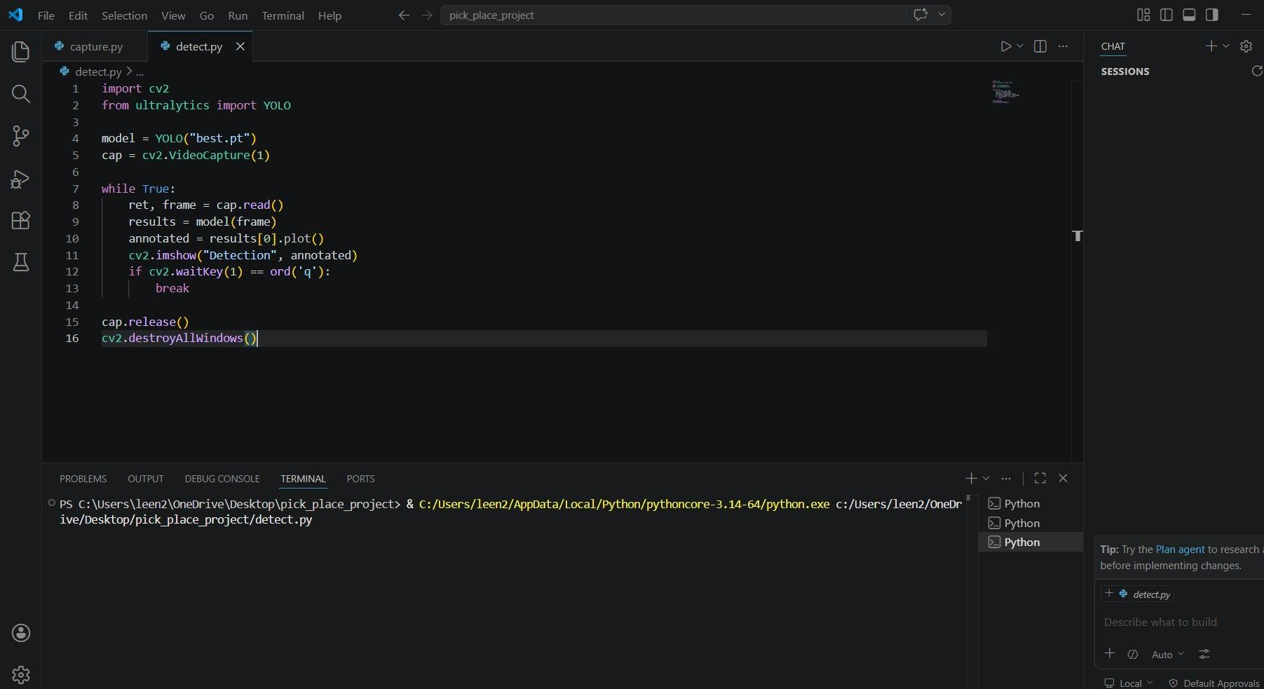
[picture p52: figure]

Live camera detection output

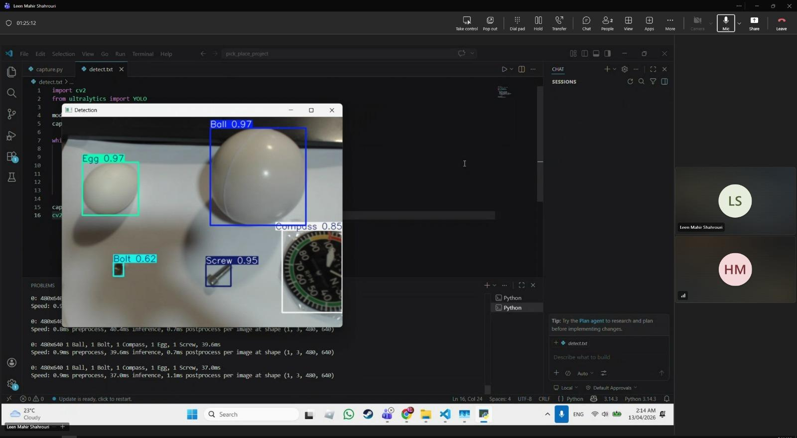
[picture p53: figure]
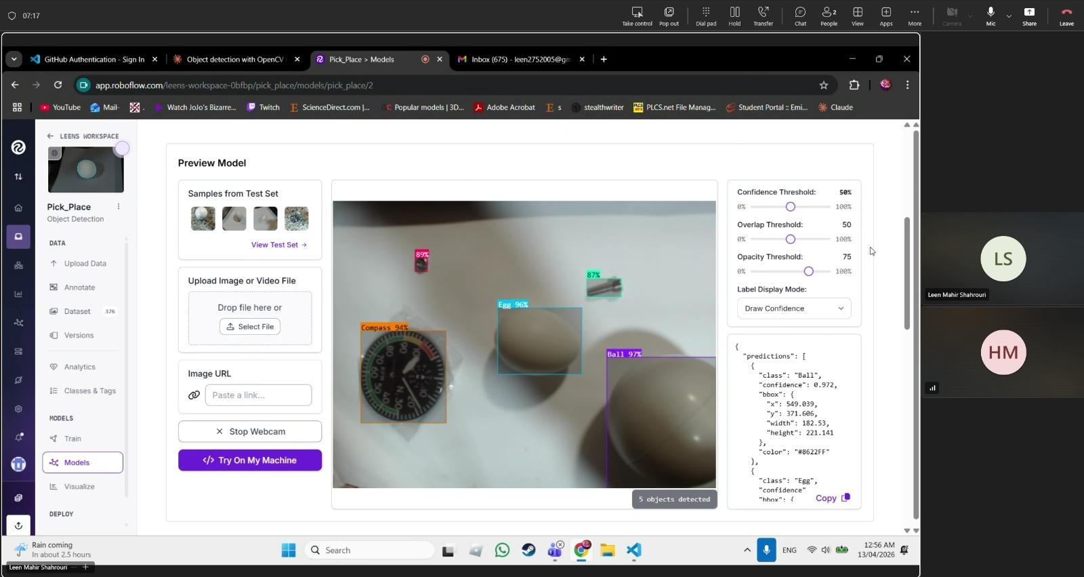
[picture p54: figure]

Detected: Ball 0.97 · Egg 0.97 · Screw 0.95 · Compass 0.85 · Bolt 0.62

Mechatronics System Design 101 · Leen's Group · Week 6

## Slide 11

Mohamed — Member · Compressor Candidates Compared

Candidate | Vacuum Level | Flow Rate | Weight | Voltage | Noise | Selected?
Mini Piston Compressor | ~−60 kPa | Moderate | Heavy (>200 g) | 12–24V | High | ✗
Venturi Generator | ~−80 kPa | Needs air line | Very light | N/A (pneumatic) | Silent | ✗
12V DC Diaphragm Compressor | −70 to −85 kPa | 3–6 L/min | ~65 g | 12V shared rail | Low | ✓

★ Highlighted row = selected compressor

## Slide 12

Mohamed — Member · Selected: 12V DC Diaphragm Compressor

DC 12V

DIAPHRAGM
COMPRESSOR

↑ Illustrative diagram

Operating Voltage:

12V DC

Vacuum Level:

−70 to −85 kPa

Flow Rate:

3–6 L/min

Weight:

~65 g

IN

OUT

Current Draw:

~0.3–0.5 A

Noise Level:

Low (oil-free)

## Slide 13

Mohamed — Member · Selection Justification

01

Voltage Compatibility

Runs at 12V DC — shares the existing power rail with the JGA25-370 base motor, no extra supply needed.

Control Flow

Arduino R4

GPIO trigger signal

▼

MOSFET Switch

ON / OFF control

▼

12V Compressor

Generates vacuum

▼

Suction Cup

Grips the object

02

Sufficient Vacuum

Achieves −70 to −85 kPa, well above the threshold needed to lift the project's lightweight flat-surfaced target objects.

03

Compact & Lightweight

At ~65 g, it can mount near the end effector, cutting tube length and delivering faster suction response.

04

Simple Arduino Control

Switched via a MOSFET on an Arduino R4 digital GPIO pin — fits existing firmware without added complexity.

## Slide 14

Mohamed — Member · Next Steps – Week 7

01

🛒 Procure Compressor

Order the selected 12V DC diaphragm compressor for assembly and integration.

02

📐 CAD Integration

Update Autodesk Inventor model to include compressor mounting bracket on the arm.

03

⚡ MOSFET Wiring Circuit

Design and build the switching circuit for Arduino R4 GPIO digital control of compressor ON/OFF.

04

🧪 Suction Force Test

Benchmark suction force against target objects to verify reliable grip before full integration.

PickMasters | MEC 483 – Spring 2026 | Abu Dhabi University

## Slide 15

Helal — Member · Firmware & Control Integration

Accomplished (since last report)

- Wrote combined Arduino firmware merging manual gamepad control and automatic Python command input into a single unified sketch

- Integrated IMU sensor readings into the Arduino code — wrist joint now auto-corrects to keep end effector pointing downward

- All three control modes (gamepad, Python auto, IMU levelling) run simultaneously without conflict

Combined firmware — what it does

Manual mode

Gamepad input via Bluetooth controller — each joint mapped to a stick/button

Auto mode

Python sends serial commands (e.g. S1:90) — Arduino receives and executes

IMU levelling

Reads IMU orientation continuously — adjusts wrist servo to keep cup level

In progress

- CAD model — wrist joint and end effector mount still outstanding

Next week plan

- Complete wrist joint CAD

- Begin end effector CAD design

- Follow up on 3D print status

Help needed / questions

3D printed parts still not received — wrist and end effector CAD cannot be verified for fit until parts arrive.

Mechatronics System Design 101 · Leen's Group · Week 6

## Slide 16

Demo

IMU — End Effector Auto-Levelling

Helal — Week 6 · Wrist joint corrects in real time to keep suction cup pointing downward

Mechatronics System Design 101 · Leen's Group · Week 6

To insert video:

Insert tab

→ Video

→ This Device

Select file

▶

## Slide 17

Looking ahead

Week 6

Wrap-up

✓

Object detection & classification working in OpenCV

Week 7

Complete CV coordinate mapping

✓

Arduino controllable via gamepad AND Python commands

CAD + 3D print resolved

✓

✓

IMU integrated — end effector auto-levels to point downward

ROS2 Ubuntu VM installed — setup beginning

Week 7

Continue ROS2 setup

⚠

CV coordinate mapping not yet done — auto pipeline on hold

Week 7

Finalise end effector design

✗

3D prints delayed again — reprinting, blocking assembly

Week 7

Vision + control fully connected

Assembly + Gazebo digital twin

Week 8

Week 10

Mechatronics System Design 101 · Leen's Group · Week 6
