helalsaeed2003/RoboticArm.github.io/media/PowerPoints/RoboticArm_Week7.pptx

WEEK 7

Robotic Arm

Pick & Place System

Weekly Progress Report · Mechatronics System Design 101

Leen's Group · Leen · Mohamed · Helal

## Slide 2

Week 7 — Snapshot

What we worked on this week

In-person meetup + 3D parts collected & fixed

First in-person session. Collected long-delayed 3D printed parts. Servo motor fittings were wrong dimensions — team manually cut and corrected the parts on the spot.

Status

Schedule

Recovering

01

3D parts

OpenCV — mapping progress

Through trial and error, camera vision now detects if an object is to the left or right and sends movement commands to the Arduino base motor accordingly.

Fixed ✓

02

OpenCV

Progressing

ROS2

Running ✓

ROS2 installed and running

After significant learning on the new Linux OS, ROS2 is now installed and operational on the Ubuntu system — ready to begin integration work.

03

Assembly

Pending

Mechatronics System Design 101 · Leen's Group · Week 7

✓ Major win: team met in person, collected 3D parts, and corrected servo fittings on the day — assembly is now unblocked.

CAD

On track

## Slide 3

Project Schedule — Gantt Chart

[ Paste Gantt Chart Image Here ]

Mechatronics System Design 101 · Leen's Group · Week 7


## Slide 4

Milestones & Deliverables

Deliverable

Target

Status

This week

CAD model complete

Week 7

Nearly done

Parts corrected — final CAD to finish this week

New part prints

Week 8

Ordered

Corrected dimensions sent for reprint

Camera vision (OpenCV)

Week 8

Progressing

Left/right detection + base motor commands working

End effector + pump

Week 8

In progress

Pump being sourced this week

Control system

Week 8

On track

Gamepad + Python + CV commands all functional

ROS2 / Digital twin

Week 10

Running ✓

ROS2 installed and operational on Ubuntu

Full assembly

Week 10

Unblocked

Parts in hand — assembly begins once reprints arrive

Control system complete

Week 11

On track

CV pipeline sending commands to Arduino

Mechatronics System Design 101 · Leen's Group · Week 7

## Slide 5

Issues, Risks & Action Items

Current issues & risks

Servo fittings — wrong dimensions

3D printed motor mounts did not fit. Team manually cut parts to correct on the day — new accurate parts sent for reprint.

Action items

Complete CAD model

Helal

Resolved

Week 7

OpenCV mapping incomplete

Left/right detection working but full coordinate mapping to arm workspace not yet done — auto pick-and-place still pending.

Source and buy suction pump

Mohamed

Week 8

Medium

Finish OpenCV coordinate mapping

Leen

Week 8

Begin ROS2 arm integration

All

Assembly not yet tested

Physical assembly could not be completed this week due to fitting issues. Unblocked now — to proceed when reprints arrive.

Medium

Week 8

Assemble arm once reprints arrive

All

Week 8

ROS2 integration not started

ROS2 is installed and running. Integration with arm control pipeline yet to begin — must start Week 8.

Low

Test full control pipeline end-to-end

All

Week 8

Mechatronics System Design 101 · Leen's Group · Week 7

## Slide 6

Helal

Member

Individual

Updates

What each member did, what they will do, what they need.

Leen

Group Leader

Mohamed

Member

## Slide 7

Leen — Group Leader · OpenCV & Arduino Control

Accomplished (since last report)

- Integrated OpenCV detection with Arduino motor control

- Object detected on left → base motor turns left until centred

- Object detected on right → base motor turns right until centred

- Closed-loop centering behaviour confirmed working

Control loop — how it works

Camera captures frame

OpenCV processes live video feed

Object position detected

Bounding box centre compared to frame centre

Left / right decision

If object is left → turn left. If right → turn right.

Command sent to Arduino

Serial command adjusts base servo until object is centred

1

2

3

In progress

- Camera producing too many false detections — collecting more training data

- Full x/y coordinate mapping to arm workspace

4

Next week plan

- Gather and annotate more training data for camera

- Improve detection accuracy — reduce false positives

- Complete full coordinate mapping for auto pick-and-place

Current issue — false detections

The camera is detecting too many incorrect objects. This is a training data problem — the model has not seen enough examples to reliably distinguish the target objects from the background and other items. More labelled images need to be collected and the model retrained before the system can be used reliably for auto pick-and-place.

Mechatronics System Design 101 · Leen's Group · Week 7

## Slide 8

Demo

OpenCV — Object Detection

Leen — Week 7 · Left/right detection sending base motor commands to Arduino

[ Insert video here ]

Mechatronics System Design 101 · Leen's Group · Week 7

To insert video:

Insert tab

→ Video

→ This Device

Select file

▶

## Slide 9

3D Printed Part Adjustments

Mohamed • Hardware & Firmware

Parts Adjusted

Base and shoulder 3D printed links were too tight for the servo motor shaft and required post-processing.

Method – Dremel

A Dremel rotary tool was used in the lab to widen the mounting holes and clean up the tight printed tolerances.

✅ Parts Fixed

Both parts are now fully adjusted and seat correctly on the servo shafts — no reprinting required.

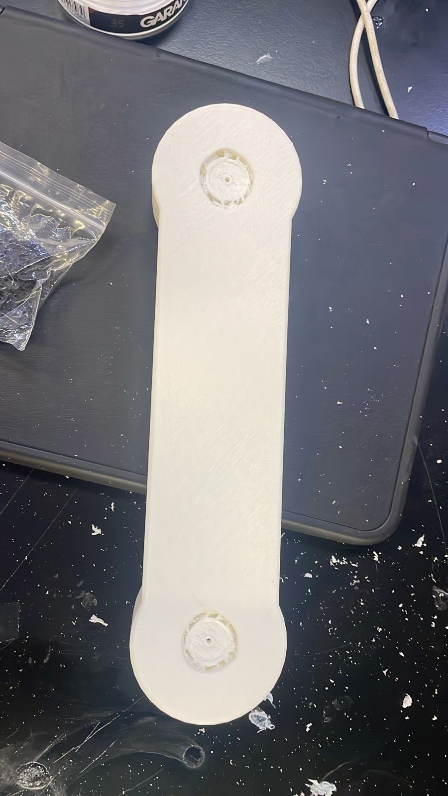
[picture p55: figure]

3D Printed Arm Link

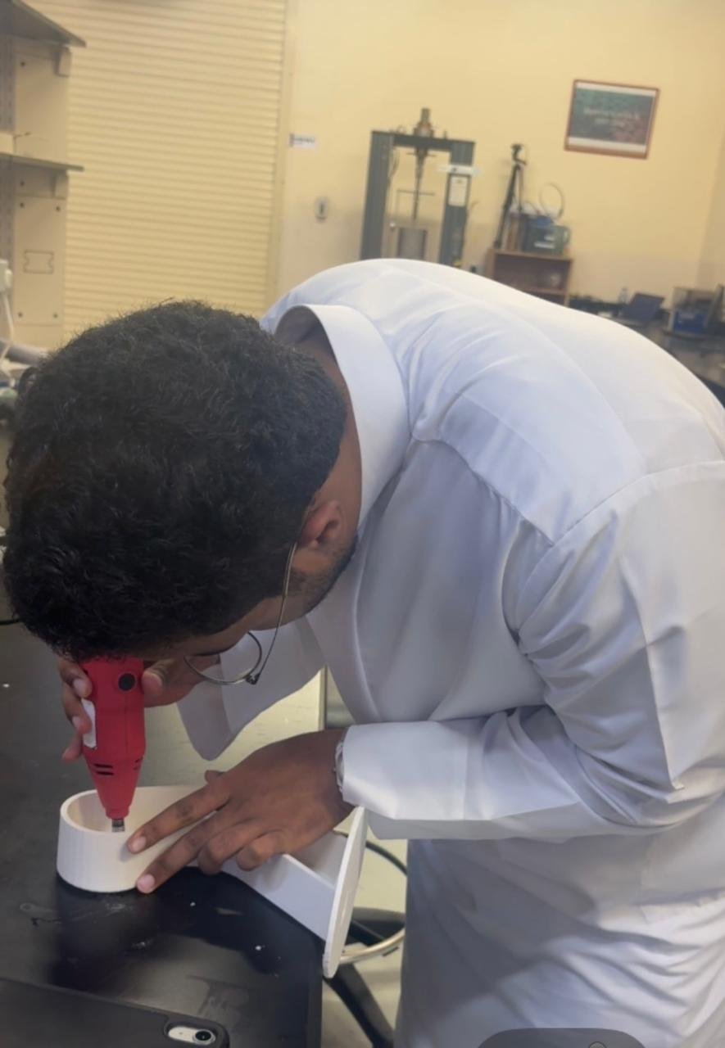
[picture p56: figure]

Dremel Adjustment in Lab

## Slide 10

End Effector CAD – Hybrid Design

Hybrid mechanism: vacuum suction cup + gear-driven mechanical claws. Suction cup hole diameter TBD pending servo motor fitment confirmation.

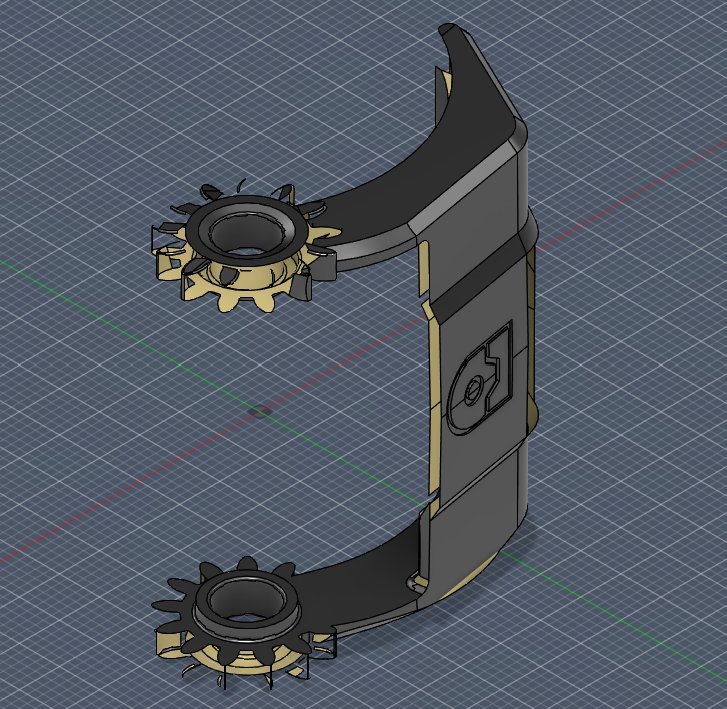
[picture p57: figure]

Claw Mechanism

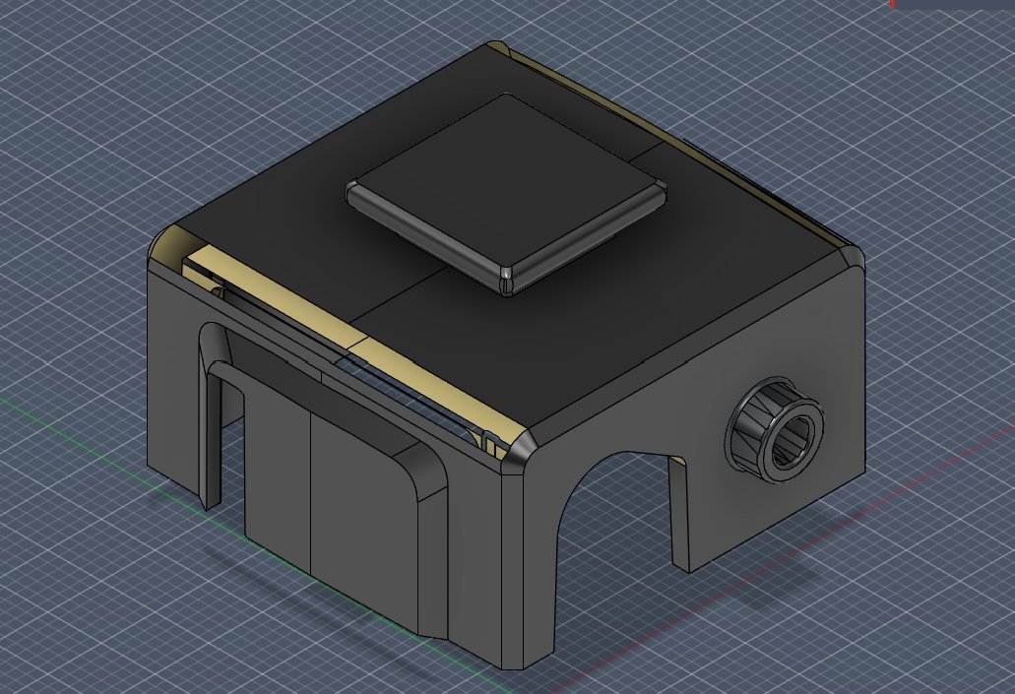
[picture p58: figure]

Housing – Side View

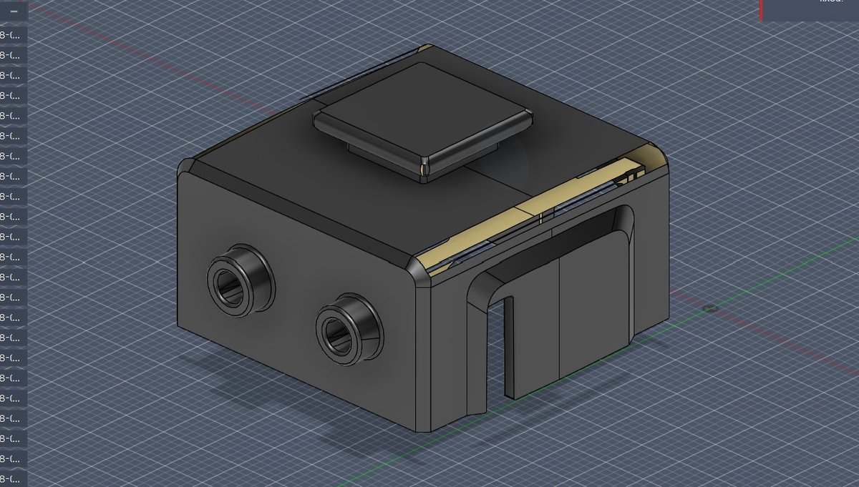
[picture p59: figure]

Housing – Front Port View

🦾 Gear-Driven Claws

Two symmetrical claws actuated by a gear mechanism grip the object securely from the sides.

💨 Suction Cup Port

Hole diameter TBD — pending servo motor fitment confirmation in next CAD revision.

🔩 Material & Mounting

3D printed PLA/PETG. Housing mounts directly onto the wrist joint of the arm.

## Slide 11

Vacuum Pump – Market Research

Visited Besomi Electronics and a local electrical shop. Also searched online. Key challenge: most pumps do not list port diameter — critical for suction force calculation (F = P × A). Research ongoing.

Gikfun Mini DC 6V–12V R385 Diaphragm Pump

Amazon.ae • AED 36

Only option found with port dimensions clearly listed. Port ID of 5 mm gives a contact area of 19.6 mm², sufficient to lift the target objects at the compressor's operating vacuum.

1

370 Mini Vacuum Pump

DFRobot / Local • AED 26.20

Cheapest option available. Port specs are not provided — physical measurement would be required before confirming suitability for the required suction force.

2

Vacuum Pump – 12V

SparkFun / Local • AED 86.24

Most reputable brand with known reliability. Port specs unavailable online. Highest price and long lead time make this less practical for the current project timeline.

3

## Slide 12

Pump Options – Specification Comparison

Pump | Voltage | Port ID | Contact Area | Price (AED) | Availability | Port Specs Listed?
Gikfun R385 (Amazon.ae) | 6–12V DC | 5 mm | 19.6 mm² | 36 | In stock | ✓ Yes
370 Mini Pump (DFRobot) | TBC | Not listed | Unknown | 26.20 | In stock | ✗ No
SparkFun 12V (Local) | 12V DC | Not listed | Unknown | 86.24 | 2–3 weeks | ✗ No

Suction Force Estimate – Gikfun R385 (only option with known Port ID)

F = P × A → Port ID = 5 mm → A = π/4 × (0.005)² = 19.6 mm² | At 70 kPa: F = 70,000 × 0.0000196 ≈ 1.37 N (~140 g) ✓ Sufficient for target objects.

## Slide 13

Next Steps – Week 8

01

🔍 Continue Pump Research

Visit more suppliers and search online for pumps with port specs listed. Finalise pump selection before procurement.

02

📐 Finalise Suction Port Size

Confirm servo motor fit in CAD and determine suction cup hole diameter for the end effector housing.

03

🖨️ Begin Printing End Effector

Start 3D printing the end effector housing and claw components once suction port diameter is confirmed in CAD.

04

🔩 Full Arm Assembly

Assemble all joints with servos and test full range of motion across all 4 DOF before system integration.

PickMasters | MEC 483 – Spring 2026 | Abu Dhabi University

## Slide 14

Helal — Member · ROS2, Linux & CAD

Accomplished (since last report)

- Attended in-person session — collected 3D printed parts

- Helped identify and manually correct servo motor fitting dimensions on the day

- Learned Linux OS fundamentals to support ROS2 workflow

- Installed ROS2 successfully on Ubuntu virtual machine

- Progressed through ROS2 setup — reached RViz configuration stage

ROS2 setup — where we are

Installed & configured ✓

Installed and running ✓

Reached — setup in progress

Arm model — not yet started

ROS2 ↔ Arduino — not yet started

Ubuntu VM

ROS2

RViz

In progress

- RViz setup and arm model visualisation — continuing next week

URDF model

Joint control

Next week plan

- Complete RViz arm model setup

- Begin ROS2 joint control integration

- Finalise CAD model — wrist & end effector

Help needed / questions

Linux and ROS2 are new tools — steep learning curve is slowing progress. More time needed on RViz and URDF modelling before arm integration can begin.

Mechatronics System Design 101 · Leen's Group · Week 7

## Slide 15

Looking ahead

Week 7

Wrap-up

✓

First in-person session — team collaboration working

Week 7

Finalise CAD model

✓

3D parts collected and servo fittings corrected on the day

Corrected reprints arrive

✓

✓

OpenCV: left/right detection sending base motor commands

ROS2 installed and running on Ubuntu

Week 8

Full OpenCV coordinate mapping

⚠

Full coordinate mapping not yet done — auto pipeline pending

Week 8

Buy pump + begin end effector build

⚠

Assembly awaiting corrected reprint parts

Week 8

Begin ROS2 arm integration

Full assembly + Gazebo digital twin

Week 8

Week 10

Mechatronics System Design 101 · Leen's Group · Week 7
