helalsaeed2003/RoboticArm.github.io/media/PowerPoints/RoboticArm_Week8.pptx

WEEK 8

Robotic Arm

Pick & Place System

Weekly Progress Report · Mechatronics System Design 101

Leen's Group · Leen · Mohamed · Helal

## Slide 2

What we worked on this week

Week 8 — Snapshot

Status

CAD — wrist & base designed

Wrist link and base modelled in Autodesk Inventor. CAD model still in progress — joints not yet animating.

RViz — joints imported

CAD model imported into RViz. Joints are visible in simulation but not yet moving — next step is URDF joint configuration.

CAD

In progress

01

02

RViz / ROS2

Imported

Detection

Improved ✓

Detection improved

Switched to higher resolution images and adjusted HSV thresholds — false detection rate reduced significantly.

Suction pump ordered

370 mini vacuum pump selected and ordered — awaiting delivery for end effector assembly.

Pump

03

04

Ordered

End effector

Behind

Assembly

Blocked

Mechatronics System Design 101 · Leen's Group · Week 8

## Slide 3

Project Schedule — Gantt Chart

[ Paste Gantt Chart Image Here ]

Mechatronics System Design 101 · Leen's Group · Week 8


## Slide 4

Milestones & Deliverables

Deliverable

Target

Status

This week

CAD model complete

Week 8

In progress

Wrist & base modelled — CAD still not finalised

Camera vision (OpenCV)

Week 8

Improved ✓

Higher res + threshold tuning — detection better

End effector + pump

Week 8

Behind

Pump ordered — end effector build pending delivery

Control system

Week 8

On track

Gamepad + Python + CV commands all functional

ROS2 / Digital twin

Week 10

In progress

Joints imported to RViz — motion not yet configured

Full assembly

Week 10

Blocked

Waiting on final 3D prints and pump delivery

Control complete

Week 11

On track

Pipeline nearly complete pending CV mapping

Mechatronics System Design 101 · Leen's Group · Week 8

## Slide 5

Issues, Risks & Action Items

Current issues & risks

Box dimensions unknown

Team needs box dimensions from professor before finalising wrist length and arm positioning for pick-and-place.

Action items

Request box dimensions from professor

Leen

High

Week 9

CAD & end effector behind

CAD model not yet complete and end effector cannot be built until pump arrives. Both now targeting Week 9.

Print remaining arm parts

Helal

Week 9

High

Finalise CAD model

Helal

Week 9

Configure URDF joints in RViz

Helal

RViz joints not moving

CAD imported successfully but URDF joint configuration not yet done — arm not yet animating in simulation.

Medium

Week 9

Assemble end effector once pump arrives

Mohamed

Week 9

Last parts not yet printed

Remaining 3D printed parts still outstanding — assembly cannot proceed until all parts are in hand.

Medium

Complete OpenCV coordinate mapping

Leen

Week 9

Mechatronics System Design 101 · Leen's Group · Week 8

## Slide 6

Helal

Member

Individual

Updates

What each member did, what they will do, what they need.

Leen

Group Leader

Mohamed

Member

## Slide 7

Leen — Group Leader · Detection Improvement

Accomplished (since last report)

- Switched to higher resolution images for better detection quality

- Tuned HSV colour thresholds to reduce false positives

- Detection accuracy noticeably improved — fewer incorrect detections

What changed — detection improvements

Increased → more detail per frame → better contour detection

Manually tuned lower/upper bounds → fewer false colour matches

False detection rate reduced — system more reliable in lab conditions

Image resolution

HSV thresholds

In progress

- Full x/y coordinate mapping to arm workspace

- Further detection refinement for all 3 object types

Result

Help needed / questions

Box dimensions are needed from the professor to finalise the coordinate mapping and arm positioning. Without knowing the box size and placement, the pick-and-place logic cannot be fully programmed.

Next week plan

- Complete coordinate mapping for full auto control

- Request box dimensions from professor

- Continue refining detection for all object types

Mechatronics System Design 101 · Leen's Group · Week 8

## Slide 8

Mohamed — Member · End Effector & Pump

Accomplished (since last report)

- Selected and ordered the 370 mini vacuum pump for the end effector

370 Mini Vacuum Pump — specs

370 DC mini vacuum pump

DC 6V – 12V

Suction cup end effector

On/off via Arduino digital pin + relay

Model

Voltage

In progress

- Awaiting pump delivery — end effector assembly ready to begin once it arrives

Application

Control

Next week plan

- Receive pump and begin end effector assembly

- Test suction force on representative objects

- Integrate pump control into Arduino firmware

Help needed / questions

End effector assembly and testing is fully dependent on pump arrival. Once received, suction force will be tested against all three object types (bolt, compass, ball) to confirm it can pick each one reliably.

Status

Ordered — awaiting delivery

Mechatronics System Design 101 · Leen's Group · Week 8

## Slide 9

Helal — Member · CAD & RViz

Accomplished (since last report)

- Designed wrist link CAD model in Autodesk Inventor

- Updated base CAD design

- Imported full CAD model into RViz — arm visible in simulation

RViz / ROS2 — where we are

Installed & configured ✓

Installed and running ✓

Model visible in RViz ✓

Imported — not yet moving

Not yet configured

Ubuntu VM

ROS2

In progress

- CAD model not yet fully complete

- URDF joint configuration — joints imported but not yet moving in RViz

CAD import

URDF joints

Joint motion

Next week plan

- Complete and finalise full CAD model

- Configure URDF joint limits and axes in RViz

- Begin joint motion testing in simulation

- Print remaining arm parts

Arduino link

ROS2 ↔ Arduino — not yet started

Help needed / questions

Box dimensions from professor needed to finalise wrist length in CAD. URDF joint configuration is a new area — may need additional learning time before joints animate correctly.

Mechatronics System Design 101 · Leen's Group · Week 8

## Slide 10

Looking ahead

Week 8

Wrap-up

✓

✓

Detection improved — higher res + threshold tuning

CAD model imported and visible in RViz

Week 9

Finalise CAD + print last parts

✓

Wrist and base CAD designed

Receive pump + build end effector

✓

370 mini vacuum pump ordered

Week 9

Configure RViz joint motion

⚠

CAD and end effector both behind — now targeting Week 9

Week 9

Complete CV coordinate mapping

⚠

RViz joints not yet moving — URDF config needed

Week 9

Get box dimensions from professor

Full assembly + Gazebo digital twin

✗

Box dimensions still needed from professor

Week 9

Week 10

Mechatronics System Design 101 · Leen's Group · Week 8
