helalsaeed2003/RoboticArm.github.io/bibliography.md

# Bibliography

[← Back to Home](index.md)

---

*(To be updated with references.)*
