helalsaeed2003/RoboticArm.github.io/discussion.md

# Discussion

[← Back to Home](index.md)

---

*(To be updated with analysis of results, challenges encountered, design trade-offs, and lessons learned.)*
