helalsaeed2003/RoboticArm.github.io/Pages/gantt.md

# Project Management – Gantt Chart

[← Back to Home](../index.md)

---

<iframe
  src="https://docs.google.com/spreadsheets/d/1vQUNIplIJCaTI_P2jxYhI44QH2mPTx2C/htmlembed"
  width="100%"
  height="600"
  frameborder="0"
  style="border: 1px solid #ccc;">
</iframe>

---

> *If the sheet does not load above, [click here to open it directly](https://docs.google.com/spreadsheets/d/1vQUNIplIJCaTI_P2jxYhI44QH2mPTx2C/edit?usp=drive_link).*
