helalsaeed2003/RoboticArm.github.io/Pages/bibliography.md

# Bibliography

[← Back to Home](../index.md)

---

*(To be updated with references.)*
