helalsaeed2003/RoboticArm.github.io/Pages/Media/9.png

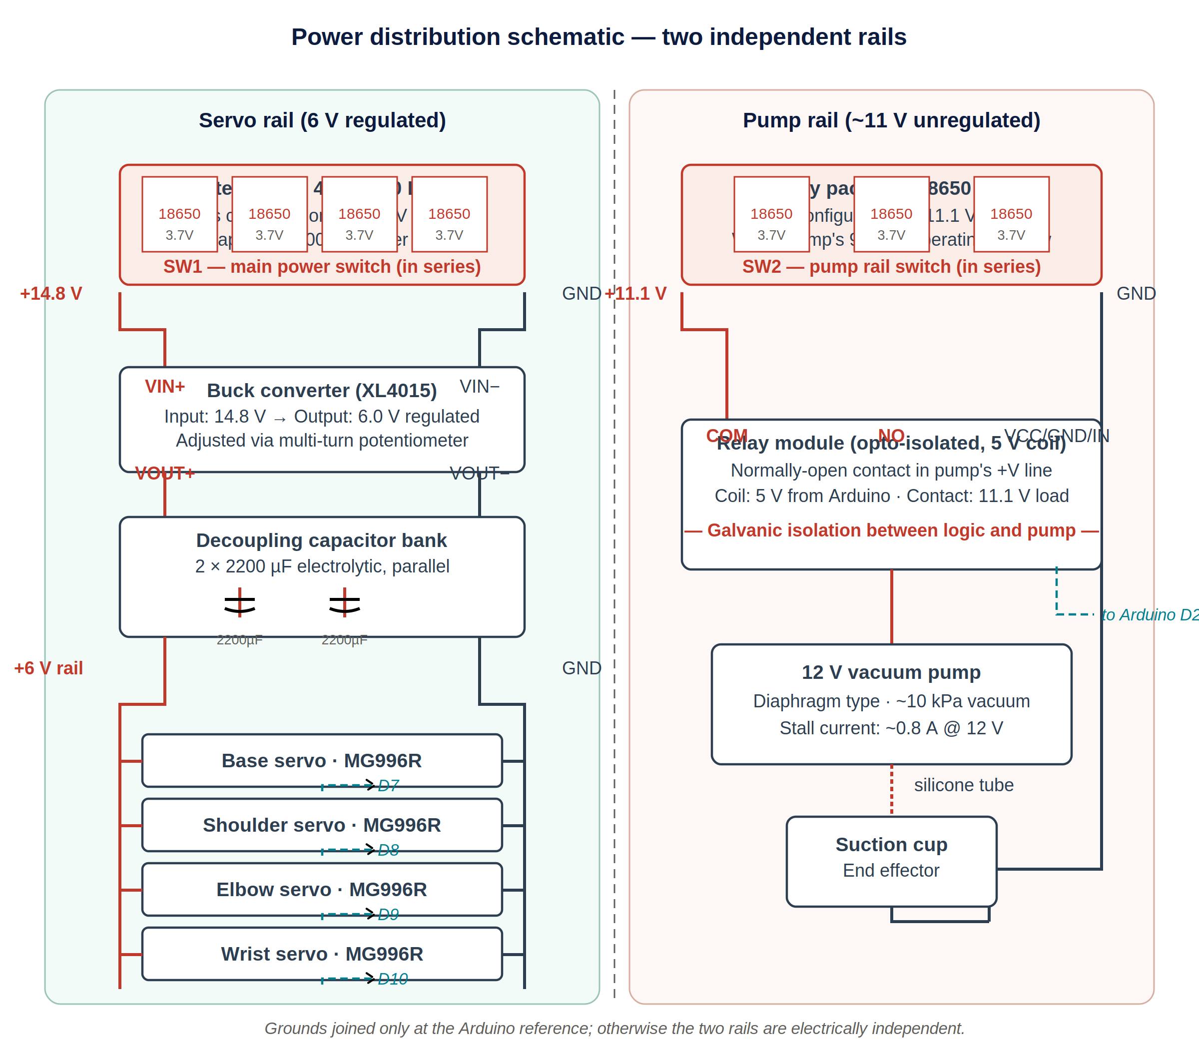
Pages/Media/9.png
