helalsaeed2003/RoboticArm.github.io/pages/bill-of-materials.md

# Bill of Materials

[← Back to Home](../index.md)

---

**Table 5 — Bill of Materials**

| Item | Quantity | Notes |
|---|---|---|
| Arduino R4 | 1 | Microcontroller |
| MG996R servo | 4 | Arm joints |
| Hobby servo (claw) | 1 | End effector claw |
| DC gear motor with wheel | 2 | Mobile base drive |
| Castor wheel | 1 | Mobile base stabiliser |
| 12 V vacuum pump | 1 | End effector suction |
| Suction cup | 1 | End effector |
| Silicone tube | ~30 cm | Pump to cup |
| L298N motor driver module | 1 | DC motor control |
| Single-channel relay module | 1 | Pump switching |
| MPU6050 IMU module | 1 | Orientation feedback |
| Logitech USB webcam | 1 | Vision input |
| Bluetooth gamepad | 1 | Manual input |
| 3.7 V Li-ion cell (18650) | 7 | 4 servo rail, 3 pump rail |
| Buck converter (XL4015 or similar) | 1 | Servo rail regulation |
| 2200 µF electrolytic capacitor | 2 | Servo rail decoupling |
| PLA filament | ~500 g | Arm structural parts |
| 3 mm acrylic sheet | ~600 × 600 mm | Mobile base platforms |
| M3 screws and nuts | Assortment | Mechanical fasteners |
| Hookup wire | ~5 m | Wiring |
| Standoff columns | 4 | Base platform spacing |

---

[← Back to Home](../index.md)
