helalsaeed2003/RoboticArm.github.io/results.md

# Results

[← Back to Home](index.md)

---

## Demo Video

<iframe src="https://drive.google.com/file/d/1za2xlb5PNdxxTFzdW1wSl5EE5Ca-O-1R/preview" width="640" height="480" allow="autoplay"></iframe>

*(Additional results and data to be added after testing.)*
