helalsaeed2003/RoboticArm.github.io/OpenCV/PICK&PLACE/capture.py

import cv2

cap = cv2.VideoCapture(1)

while True:
    ret, frame = cap.read()
    if not ret:
        print("Camera error!")
        break

    cv2.imshow("Camera", frame)

    if cv2.waitKey(1) == ord('q'):
        break

cap.release()
cv2.destroyAllWindows()
