helalsaeed2003/RoboticArm.github.io/(commit log)

2026-04-12 rename Arduino directory to Arduino Code
2026-04-14 Update AutoMode.ino
    I changed the base pin from 9 to 7
2026-04-20 OPENCV & ARDUINO
2026-05-17 Redesign arm for 3-servo + differential DC drive base
    - ManualMode.pde: left stick drives DC motors (differential), right stick
    controls shoulder/elbow, Button 1 toggles pump, wrist remains IMU auto-level.
    New serial protocol: M <l> <r>, P 1/0, plus existing 2/3 angle commands.
    - data/PickMasters: new GameControlPlus config mapping LeftX/LeftY, RightX/RightY
    and PumpButton for the updated layout.
    - ManualDrive/ManualDrive.ino: new Arduino firmware using AFMotor (L293D shield)
    for two DC motors, Servo library on A1–A3 for shoulder/elbow/wrist, pump relay
    on A0, MPU6050 on A4/A5 for wrist auto-leveling. All analog pins used first.
    [ManualDrive.ino, ManualMode.pde]
2026-05-17 Rename ManualMode sketch to DriveControl
    Processing requires the .pde file to match its folder name.
    Renamed ManualMode/ManualMode.pde → DriveControl/DriveControl.pde
    and moved all data/ config files along with it.
2026-06-10 Add ArmController firmware and rewrite DriveControl for combined serial protocol
    - New ArmController.ino: 4 servos (A0-A3), AFMotor DC drive (M1/M2),
    active-LOW pump relay on pin 2, MPU6050 wrist auto-leveling with
    50-sample calibration, cal button on pin 9, single combined-message
    serial parser (S..,M..,P..,W..)
    - DriveControl.pde: digital left-stick drive with pivot turns, D-pad
    shoulder/elbow steps, right-stick wrist/hand rate control, pump and
    wrist-mode toggles, change-only + 50ms-throttled single-message sends
    - PickMasters config: add D-pad hat, cal and wrist-mode buttons
    https://claude.ai/code/session_013ENxBRxsDjXSZomZDPuL2Q
2026-06-10 Fix GameControlPlus ConcurrentModificationException and FakerInput crash on Windows
    Wrap controller init and per-frame input read in try/catch to survive
    library-level threading bugs without crashing the sketch.
    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
    [DriveControl.pde]
2026-06-10 Auto-select Arduino serial port instead of hardcoded index
    Prefer the last non-COM1 port and exit with a clear message when no
    port is found, instead of crashing with ArrayIndexOutOfBoundsException.
    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
    [DriveControl.pde]
2026-06-15 Replace L293D Motor Shield with L298N driver in ArmController
    - Remove AFMotor.h and AF_DCMotor objects
    - Add L298N pin definitions (ENA=5, IN1=2, IN2=4, ENB=6, IN3=7, IN4=8)
    - Drive motors with digitalWrite/analogWrite direction+PWM logic
    - Move servos to digital pins (shoulder=3, elbow=10, wrist=11, hand=12)
    - Move pump relay to pin 9, IMU cal button to pin 13
    - Preserve serial protocol, servo constraints, pump and IMU logic
    [ArmController.ino]
2026-06-15 Swap Shoulder servo (pin 9) and pump relay (pin 3)
    [ArmController.ino]
2026-06-15 Add interactive ComponentTest sketch for current L298N setup
2026-06-15 Move shoulder servo off suspect pin 9 to pin 13; relocate cal button to A0
2026-06-17 Set shoulder servo to pin 9 to match wiring (pump stays pin 3, cal button A0)
2026-06-17 Harden ArmController boot: I2C timeout, IMU detection, early boot msg, staggered servo startup
    - A missing/shorted IMU no longer freezes the board in setup()
    - Add Wire.setWireTimeout(3000, true) so I2C calls can't block forever
    - Detect MPU6050 via endTransmission ACK; skip calibration and disable
    wrist auto-level (with WARN) when absent, instead of hanging
    - Print 'PickMasters booting' right after Serial.begin for instant proof
    serial is alive
    - Attach servos one at a time at startup to spread inrush current
    - readPitch() keeps last value if fewer than 6 bytes returned
    - status line now reports IMU:OK/NONE
    [ArmController.ino]
2026-06-17 Add minimal PumpCheck firmware + PumpCheckDrive controller test (pump only)
2026-06-18 Remove nonexistent IMU calibration push button (CAL_BUTTON A0) from ArmController
    The physical CAL_BUTTON on pin A0 was never wired, and configuring/reading it
    held up the firmware during initialization. IMU re-zeroing is now driven solely
    by the "cal" serial command, which the DriveControl controller already sends via
    its CalButton (mapped to gamepad Button 3 in data/PickMasters).
    Claude-Session: https://claude.ai/code/session_01U6nfVgov9YDPvfaLT2hesg
2026-06-18 Add lock-on detection and DC-motor centering for pick & place
    Python (detect_and_move.py): splits the camera feed with a vertical and
    horizontal line plus a target box at the crossing. Locks onto the first
    item seen at >=80% confidence using YOLO tracking and stays focused on it
    even if confidence drops, until the operator presses 'n' for the next
    item. Spins the base (pivot) to centre on the vertical line and drives
    the base forward/back to centre on the horizontal line until the item
    fits completely inside the box.
    Arduino (PickAndMove.ino): parses PIVOT_LEFT/PIVOT_RIGHT/DRIVE_FWD/
    DRIVE_BACK/STOP commands and drives the two L298N DC motors with safe
    pulse-based motion (auto-stop on each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
2026-06-18 Open camera with DirectShow backend to avoid Windows hang
    cv2.VideoCapture with the default backend can hang for a long time when
    opening the camera on Windows. Use cv2.CAP_DSHOW and fail fast with a
    clear message if the camera index can't be opened.
    Claude-Session: https://claude.ai/code/session_016tTZ8NZLE8xGfRG5BYrx3A
    [detect_and_move.py]
2026-06-18 Make base turning gentler
    Lower the pivot PWM speed, space out motion pulses with a longer cooldown,
    and shorten the Arduino motion pulse so the base nudges toward the target
    instead of over-swinging.
    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
    [PickAndMove.ino, detect_and_move.py]
2026-06-18 Lower lock confidence to 50% and move target box lower on Y axis
    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
2026-06-19 Quit when item is fully inside the box; speed up motors a bit
    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
2026-06-20 Add PID control, fuzzy logic, safety interlock, watchdog timer, and checksum
    - ArmController: Replace proportional-only wrist control with full PID
    (Kp=1.0, Ki=0.05, Kd=0.15) with anti-windup integral clamping
    - ArmController: Add state-dependent safety interlock on pin A0 — blocks
    motor/pump actuation unless hardware signal, serial link, and IMU are all OK
    - ArmController: Add XOR checksum verification on serial frames (*XX suffix)
    - ArmController: Enable AVR hardware watchdog timer (2s, auto-reset on hang)
    - PickAndMove: Add fuzzy logic speed controller with trapezoidal membership
    functions (Small/Medium/Large error -> Slow/Medium/Fast speed) and
    centre-of-gravity defuzzification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
    [ArmController.ino, PickAndMove.ino, detect_and_move.py]
2026-06-20 Separate enhanced code into new directories, restore originals
    - Arduino Code/ArmController_PID_Safety/: PID wrist control, safety
    interlock, hardware watchdog, XOR checksum verification
    - Arduino Code/PickAndMove_FuzzyLogic/: fuzzy logic speed controller,
    hardware watchdog, FUZZY_PIVOT/FUZZY_DRIVE commands
    - OpenCV/PICK&PLACE/detect_and_move_fuzzy.py: vision script using
    fuzzy commands instead of fixed-speed commands
    - Original ArmController, PickAndMove, and detect_and_move.py restored
    Claude-Session: https://claude.ai/code/session_01KNBFYJ2GZkqENEYkRkSVpP
2026-06-20 Update control and integration docs for PID, fuzzy logic, safety, and reliability
    - control.md: Add detailed sections for PID wrist control (gains, anti-windup,
    update rate), fuzzy logic motor controller (membership functions, rule base,
    defuzzification), safety interlock (conditions, behavior), watchdog timer,
    and XOR checksum protocol
    - integration.md: Add pass/fail criteria for safety interlock, watchdog
    recovery, checksum rejection, PID levelling, and fuzzy motor control
    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
2026-06-20 Move enhanced code to Final Code/ directory
    - Final Code/ArmController_PID_Safety/ (PID + safety interlock + WDT + checksum)
    - Final Code/PickAndMove_FuzzyLogic/ (fuzzy logic speed controller + WDT)
    - Final Code/detect_and_move_fuzzy.py (vision script with fuzzy commands)
    - Update implementation paths in control.md
    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
2026-06-24 media upload
    [3.xlsx]
2026-06-24 Fix code visibility, add collapsible code sections to dev sketches
    - Rewrite style.scss with high-contrast GitHub Dark colors and !important
    overrides so code text is visible on GitHub Pages
    - Add <details> collapsible sections with scrollable code containers
    to arduino-code.md (all 16 dev sketches) and opencv-code.md
    - Fix doubled headings in embedded-control.md and modelling.md
    Claude-Session: https://claude.ai/code/session_01KUeyPsNiBoKcpkgqzgdSpA
2026-06-24 Fix collapsible code blocks: use HTML pre/code instead of markdown fences
    Kramdown does not render markdown inside HTML blocks like <details>.
    Switched all code sections to raw <pre><code> with HTML-escaped content
    so they render properly on GitHub Pages.
    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
2026-06-24 Fix YAML syntax error in _config.yml — quote values containing colons
    Claude-Session: https://claude.ai/code/session_013rLWKk5KmpDYzqD14k1YkM
